Traumflug/Generation_7_Electronics/release documents/ExtensionBoard-USB-B 1.0 Layout.png

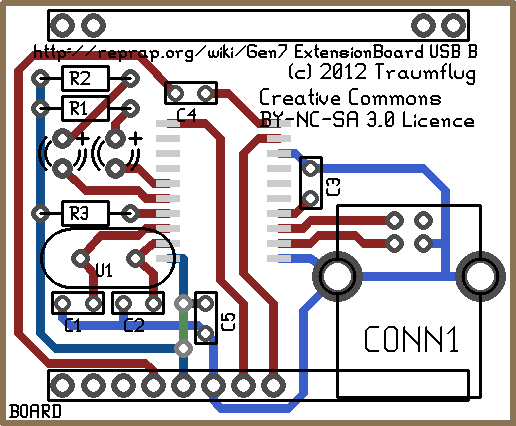
release documents/ExtensionBoard-USB-B 1.0 Layout.png
