Traumflug/Generation_7_Electronics/release documents/Gen7Board-ARM 2.0 Layout.png

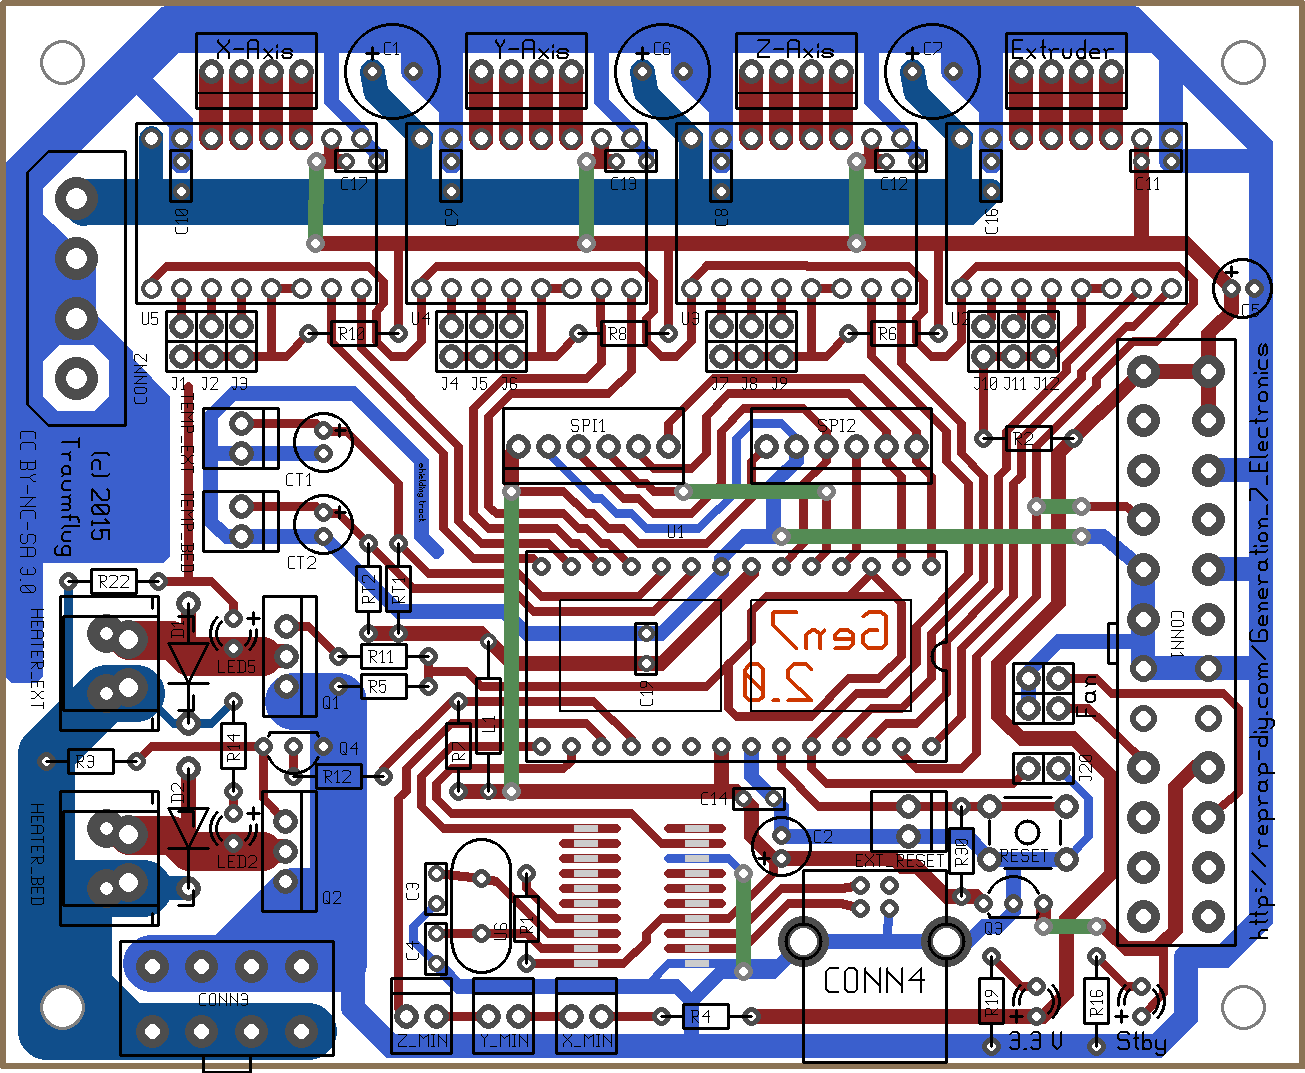
release documents/Gen7Board-ARM 2.0 Layout.png
