Traumflug/Generation_7_Electronics/release documents/OptoEndstop Layout.png

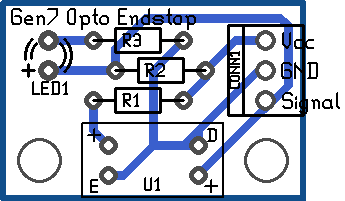
release documents/OptoEndstop Layout.png
