Traumflug/Generation_7_Electronics/release documents/SevenSwitch 1.2 Layout.png

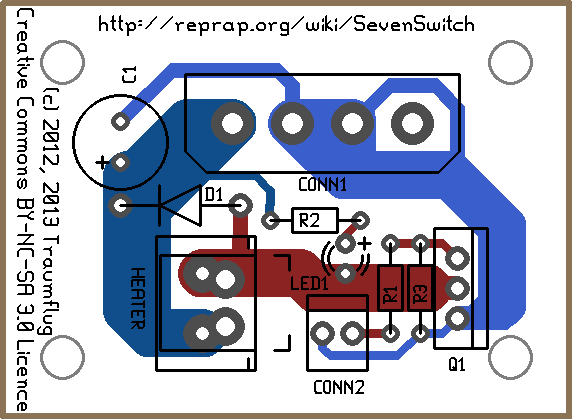
release documents/SevenSwitch 1.2 Layout.png
