Traumflug/Generation_7_Electronics/(threads)

Thread 22 (2015-03-27):

PCB Layout is not mirrored

yashunandansureka, 2015-03-27:
I was trying to make this board and while making the board using toner transfer method, i realized that the pcb layout given in the pdf for the main board is not mirrored thought at the bottom it says it is.
Can you  update it?

alfadex, 2015-03-27:
you can do this with your program, what program do you use ??

yashunandansureka, 2015-03-27:
Actually i don not use any program. I never had the need to (Until now). I was directly printing the design on glossy-paper and then transferring it on PCB.
I tried installing gEDA but its not opening on my PC.
Any options that you suggest?

alfadex, 2015-03-27:
i don't have to search in github , upload the *.brd you want to mirror , do you want to mirror it to pdf?jpg?*brd again?

yashunandansureka, 2015-03-27:
I do not have a ".brd" extension for any file which i downloaded from this repository. I have a pdf from which i am printing directly.

alfadex, 2015-03-27:
go to page 2 , it is mirrored

https://www.dropbox.com/s/tfbd6ic4uh6kdqa/Gen7Board%201.4.1%20Layout.pdf?dl=0

yashunandansureka, 2015-03-28:
thanks dude...but this is for version 1.4. I am building version 1.5.

Thread 23 (2016-09-30):

Consume on 5v With bed

feiltom, 2016-09-30:
Hello i don t understand why when i turn on my heated bed i have 1.5A on 5v.
Sorry for my english

Traumflug, 2016-10-01:
I don't even understand what you're talking about. Is it about a SevenSwitch?

feiltom, 2016-10-03:
no on my Gen7 Board-AVR 1.5
I have inverse heated bed with my jHead  and same problem
it is mount with  RLB 8743
thanck you

feiltom, 2016-10-04:
I thinck the common ground on 5v and 12v give me a false result on my ammeter

Closed 2016-10-04.

Thread 24 (2017-03-09):

Could someone help me get mcp2200-forwarder to work on an Atmega32u4 microcontroller?

taa1, 2017-03-09:
Hi,

I'm attempting to use mcp2200-forwarder.c on my PowerPC Mac Mini OS X 10.5.8 (Leopard) to talk to a [BlinkyTape device](https://www.adafruit.com/product/1605) that has a Atmega32u4 microcontroller. I changed mcp2200-forwarder.c to have the correct hardcoded USB vendor and product ID (1d50 and 605e respectively).

When I run the compiled mcp2200-forwarder, I get the following results:

~~~
$ ./mcp2200-forwarder -vvv -l /tmp/ACM0
device_added()
Device added.
find_interfaces()
Scanning interfaces ...
Interface 0x00001703.
Interface class 2, subclass 2.
Interface has 1 endpoints.
PipeRef 1: direction in, transfer type interrupt, maxPacketSize 16.
Choosing this interface as Interrupt.
Interface 0x00001A03.
Interface class 10, subclass 0.
Interface has 2 endpoints.
PipeRef 1: direction out, transfer type bulk, maxPacketSize 64.
PipeRef 2: direction in, transfer type bulk, maxPacketSize 64.
Choosing this interface as Bulk.
... interface scan done.
send_bridge_setup()
Failed to take down DTE & RTS. Ignoring. (e000404f)
Failed to set baud rate & co. Ignoring. (e000404f)
Failed to raise DTE & RTS. Ignoring. (e000404f)
Unable to set up USB-UART bridge. (e000404f)
close_interface()
device_removed()
pty_open()
Terminal name: /dev/ttys002
Created symlink to /tmp/ACM0
~~~

When I start a second shell session and run a perl script to use `/tmp/ACM0`, nothing happens on the BlinkyTape device and there's no error displayed. The perl script acts like it is happily sending the data to the BlinkyTape device because it takes a few seconds to do so, just like would happen if it was working correctly.

When I return to the first shell session running mcp2200-forwarder, it shows only one new line:

~~~
pty_read(), event 0x0002
~~~

When I contacted the BlinkyTape development team, I got these responses (edited for brevity):

> It's a little hard to tell from the source code, but a potential issue is that the BlinkyTape is actually a composite USB device, meaning that it supports a few other interfaces besides TTY-ACM (this was to make it compatible with the default Arduino Leonardo firmware). It looks like that code is ... finding the right interfaces, however I'm not sure how to interpret the addresses '0x00001703' or '0x00001A03'. [The output from USB Prober] shows that the computer is seeing the USB device just fine, so I think you're on the right track.

Output from USB Prober (starting at highlighed line 81) on my Mac: http://pastebin.com/Br0najQt
Output from 'lsusb' from BlinkyTape developer's Linux machine: http://pastebin.com/xjL1jZLR

I _think_ I'm close to getting mcp2200-forwarder to work. Can anyone help?

Thread 25 (2018-06-23):

Cannot connect after programming.

ZKing1000, 2018-06-23:
I've successfully programmed my gen 7 board as shown on the wiki, but now when I try to connect from repetier host I get no response, but a communication timeout... I'm not sure what to do. I can't get any response really. I don't know how to troubleshoot this. Thanks.

alfadex, 2018-06-23:
you have to test another ftdi board

Traumflug, 2018-06-23:
I'd start with connecting by a serial port terminal (GtkTerm, PuTTY, ...) to see whether communications is actually faulty. Then Pronterface. Repetier host is known to have its own idea of how communications should be and ignoring standards to some extents.

ZKing1000, 2018-06-23:
Connecting through the command, 'sudo screen /dev/ttyACM0 115200', resulted in a blank terminal. I haven't had much success installing pronterface on linux, but when I've tested it in windows, I haven't had much success either... I don't know how to get any real response from this thing.

ZKing1000, 2018-06-23:
The mcp2200 seems to functioning properly, but no response from the microcontroller, even though programming was successful.

ZKing1000, 2018-06-24:
Maybe there's some type of test firmware?... I do need to buy an oscilliscope... I assume the lpc1114 is working.

ZKing1000, 2018-11-18:
@Traumflug On second thought, are there any conditions under which you could provide my an lpc1114 or two separately? I could buy a couple from you if that is possible. Or if anyone is aware of any breakout boards I could order for the SMD form of this chip, then that may be an option, as I don't believe I can order the DIP form myself without a quote. Thanks.

Jacky2k, 2018-11-18:
Don't know what you are talking about, but you can buy breakout boards
everwhere, e.g.: https://www.adafruit.com/product/1377
You can order the chip for example at:
https://www.arrow.com/en/products/lpc1114fbd483021/nxp-semiconductors
Arrow currently has free express shipping with no minimum order amount.

Am 18.11.18 um 07:33 schrieb Holden Green:
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

Traumflug, 2018-11-18:
@ZKing1000, of course you can get a couple of them. It's not explicitly mentioned, one can get every part as a spare part: https://www.reprap-diy.com/start

Thread 27 (2023-05-10):

Gen7 1.3board with marlin 2.x firmware trying to update (is there a way?)

wasteoinc, 2023-05-10:
This is partly a question , partly a tribute and a thank you :)

I have a Gen7 1.3 board with 644p@20Mhz repetier firmware and I was trying to update to marlin 2.x . Marlin still supports our boards , but platformIO and sanguinoglu (which also has 644p) seem to give an uploading error.

I then tried arduino 1.0.5 where we have the relative board files for gen7 but this old IDE doesn't seem compatible with new marlin firmware.

So my question is , is there a path/way to upgrade to marlin 2.x , or am I banging my head to a wall?
Has anyone done it?

The board belongs to a self made PRUSA 2 that still works flawlessly :)
