Traumflug/Generation_7_Electronics/release documents/Gen7Board-ARM 2.0 Schematic.pdf

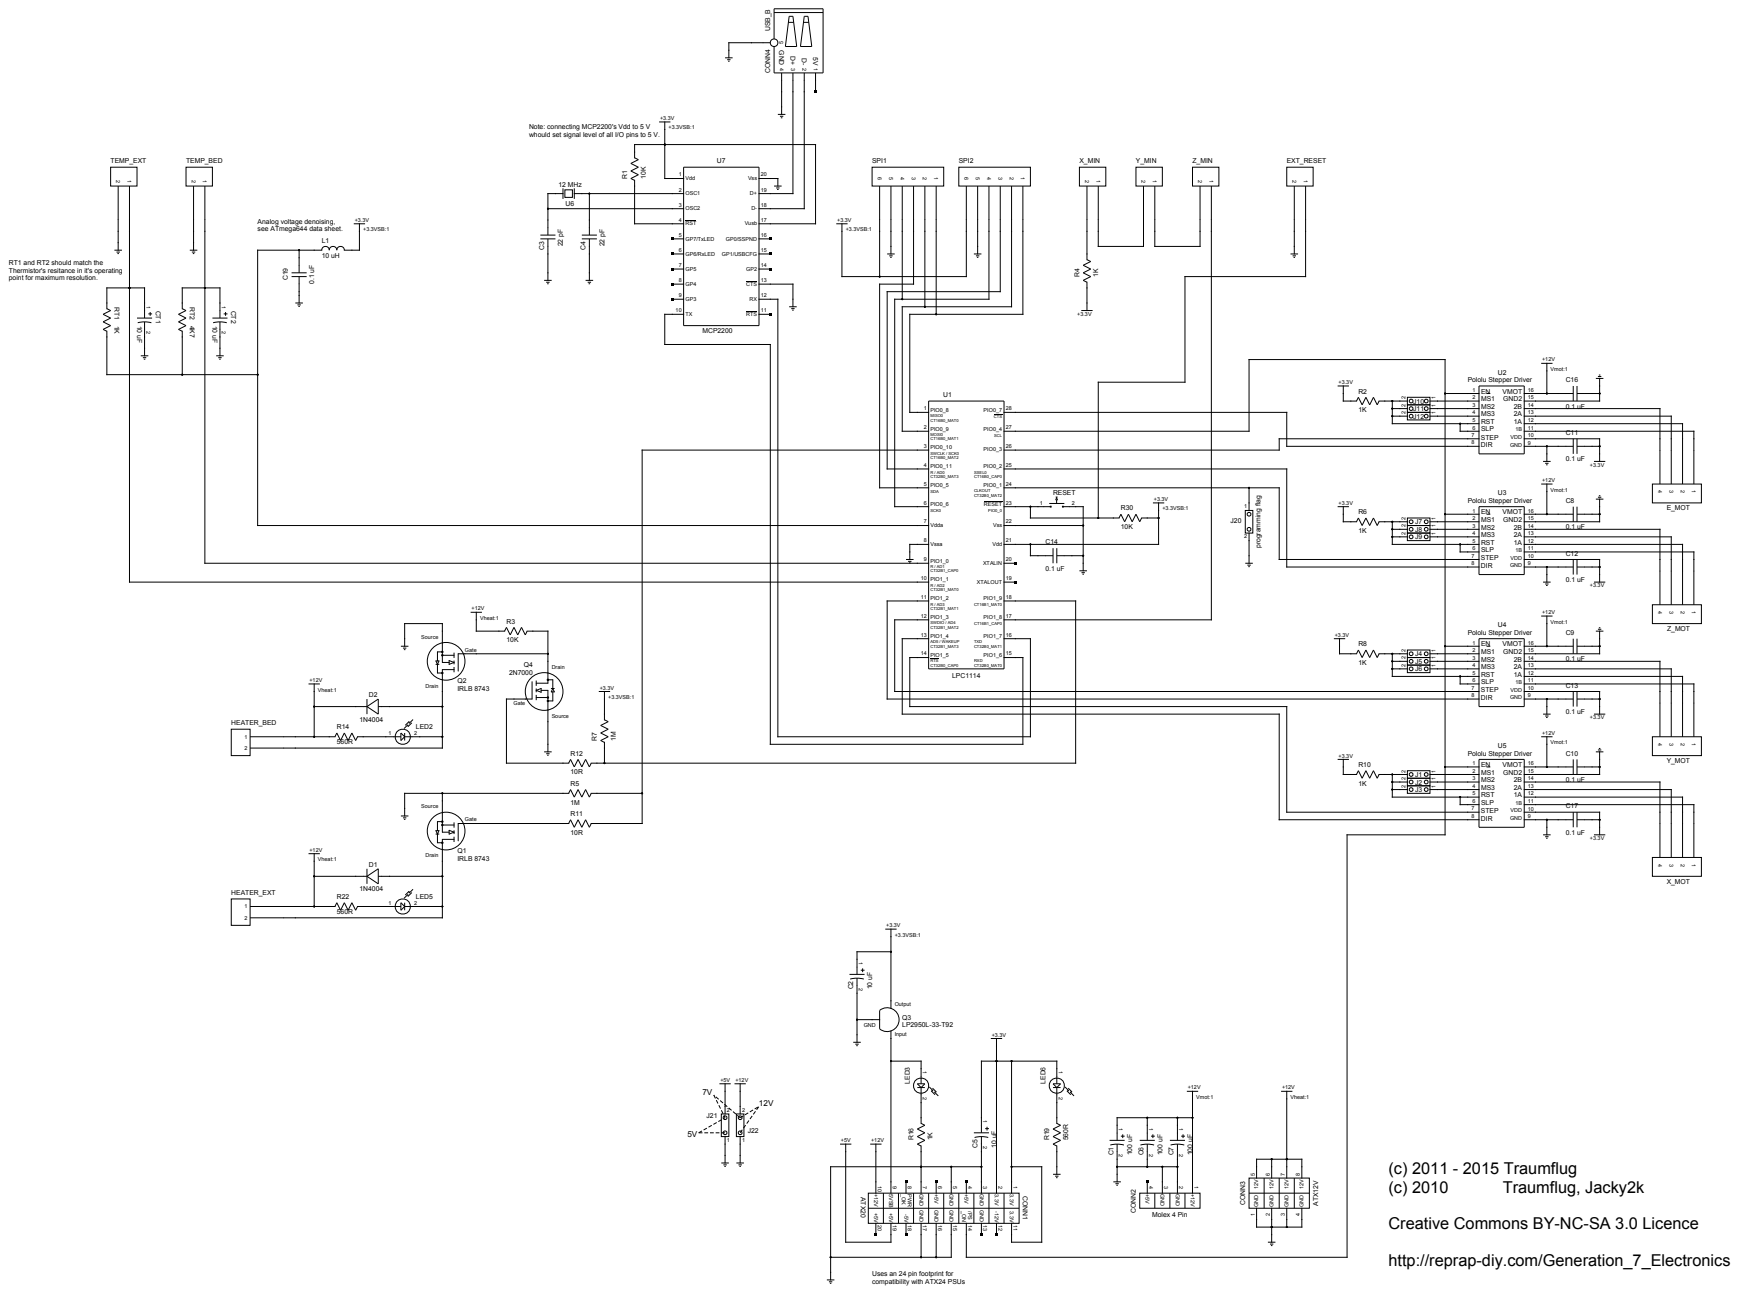
[picture p5: page 1]

whould set signal level of all I/O pins to 5 V.

RT1 and RT2 should match the
Thermistor's resitance in it's operating
point for maximum resolution.

Creative Commons BY-NC-SA 3.0 Licence

http://reprap-diy.com/Generation_7_Electronics

Uses an 24 pin footprint for
compatibility with ATX24 PSUs
