Traumflug/Generation_7_Electronics/release documents/OptoEndstop Schematic.pdf

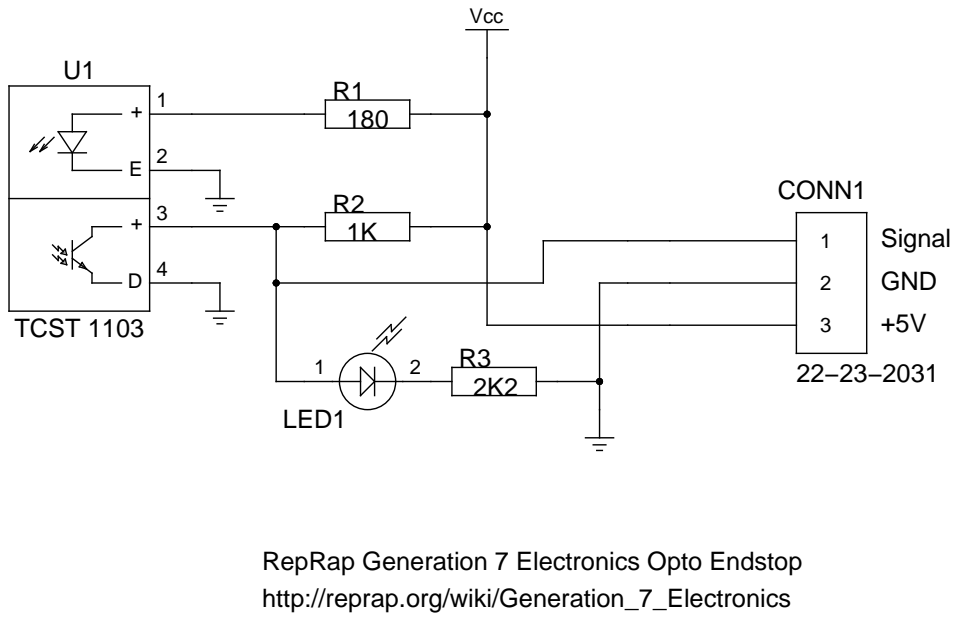
[picture p6: page 1]
TCST 1103

RepRap Generation 7 Electronics Opto Endstop
http://reprap.org/wiki/Generation_7_Electronics
