Traumflug/Generation_7_Electronics/release documents/Gen7Board-ARM 2.0 Layout.pdf

# Gen7Board-ARM.pcb

# 1. Table of Contents (This Page) Created on Thu Feb 18 16:01:24 2016

# 2. solder 3. component 4. outline 5. plated-drill 6. componentmask 7. soldermask 8. topsilk 9. bottomsilk 10. bottompaste 11. topassembly 12. bottomassembly 13. fab

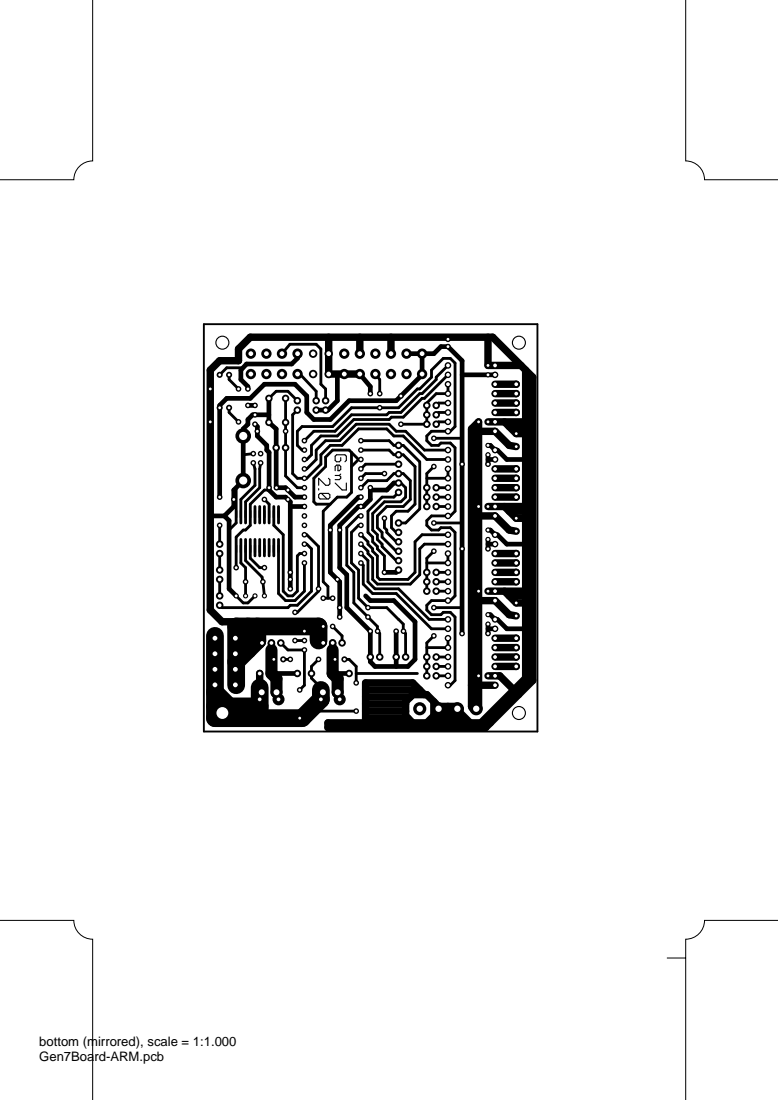
[picture p7: page 2]

bottom (mirrored), scale = 1:1.000

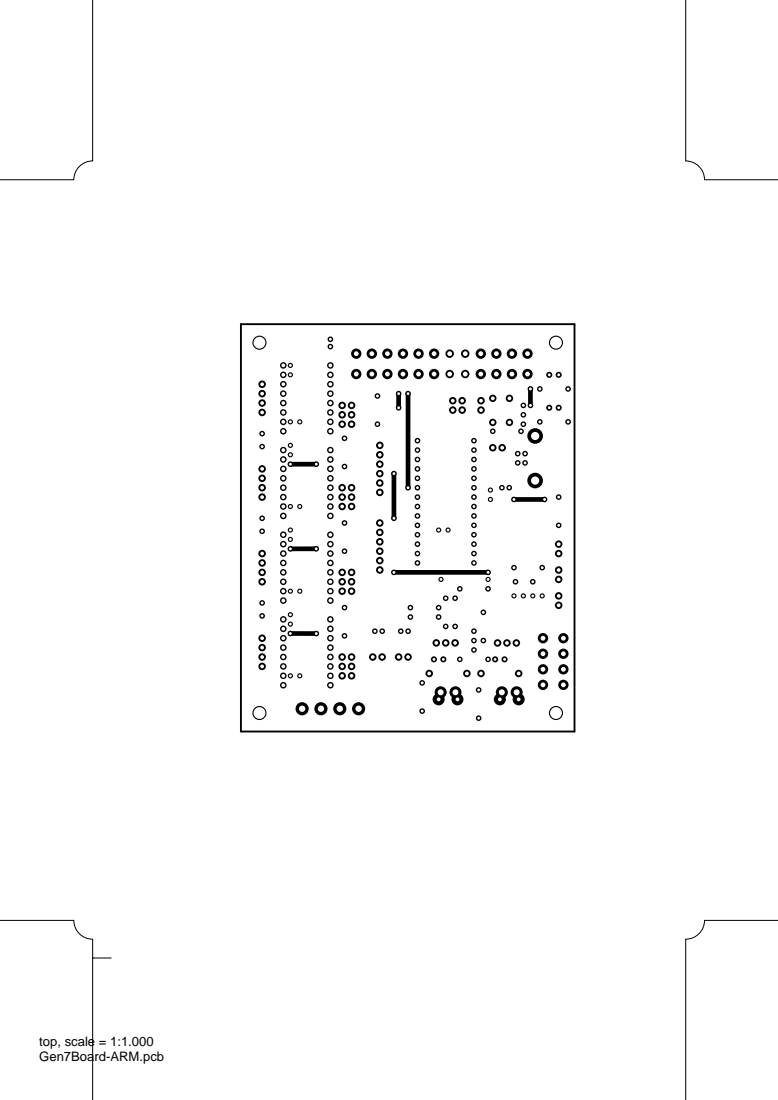
[picture p8: page 3]
top, scale = 1:1.000

outline, scale = 1:1.000

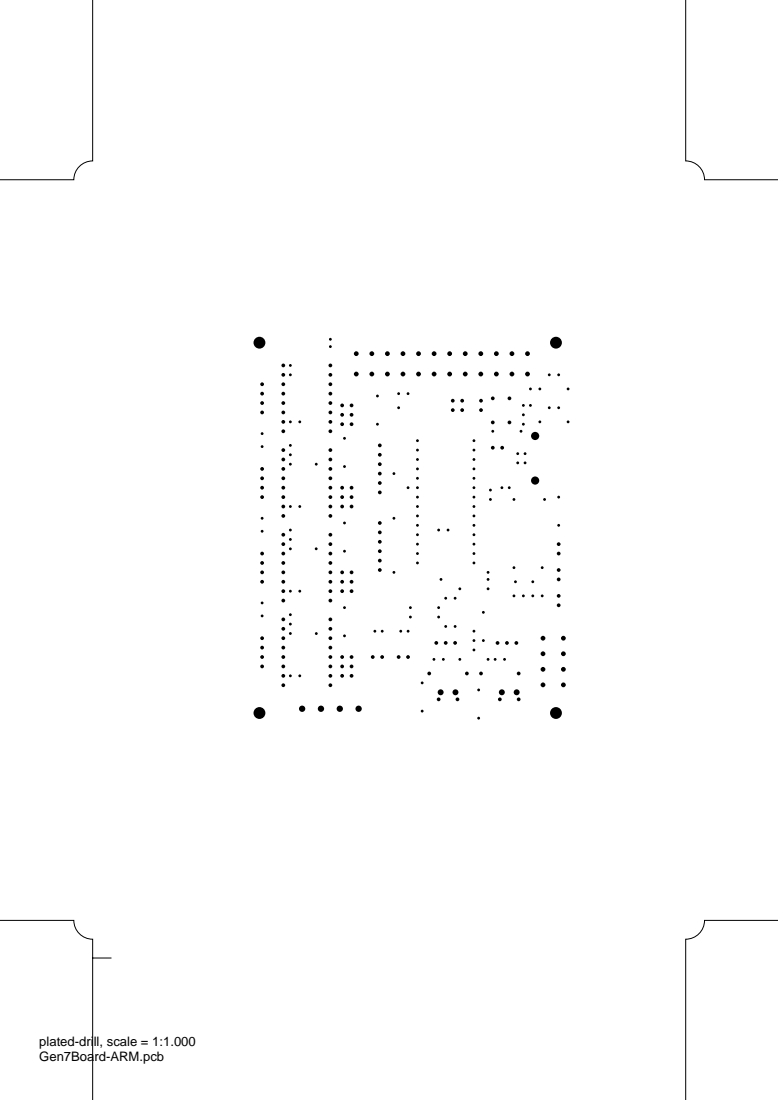
[picture p9: page 5]

plated-drill, scale = 1:1.000

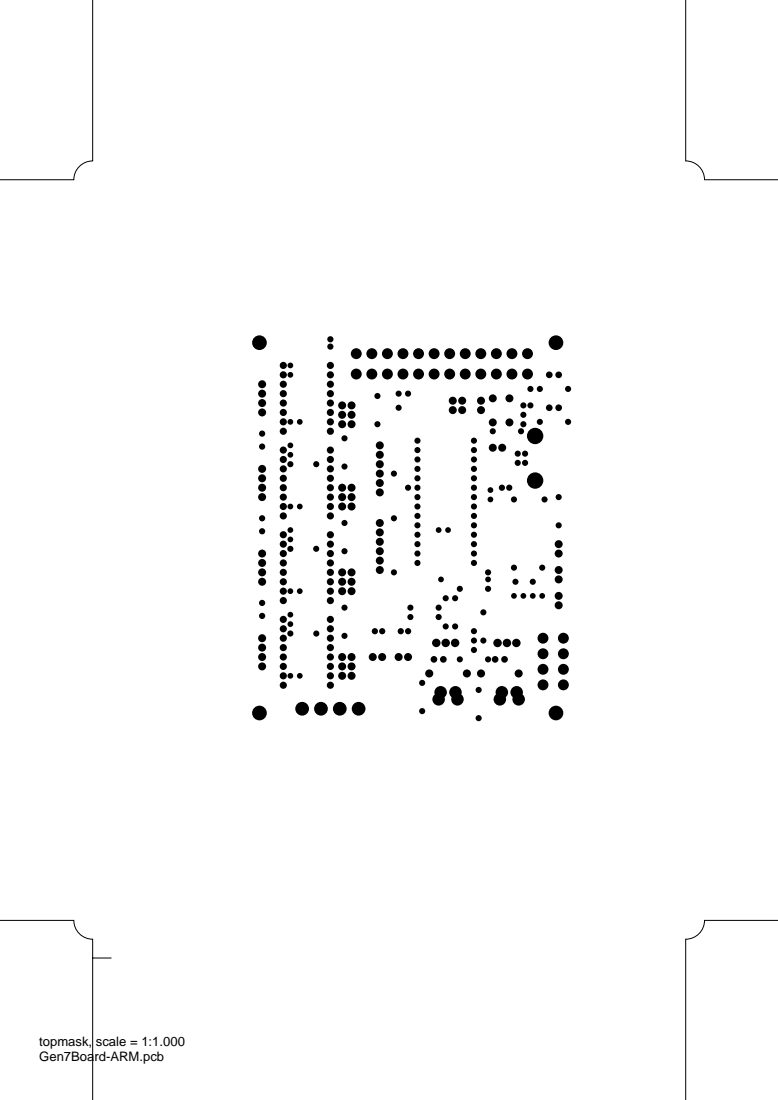
[picture p10: page 6]
topmask, scale = 1:1.000

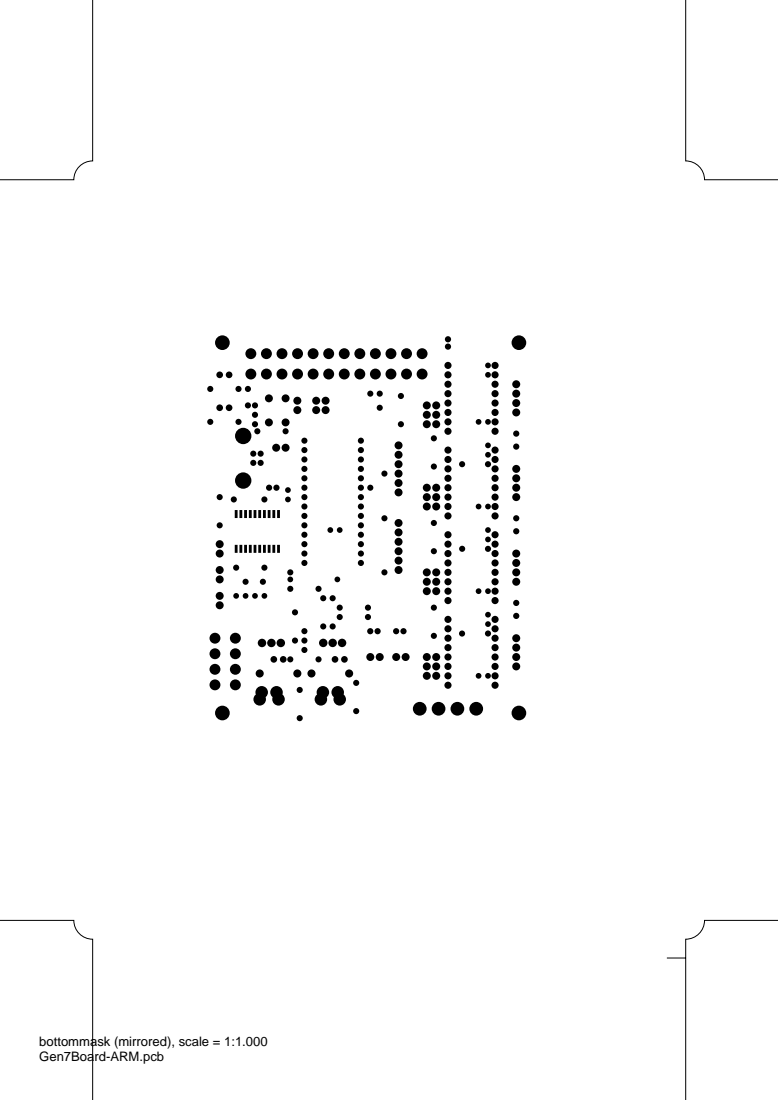
[picture p11: page 7]

bottommask (mirrored), scale = 1:1.000

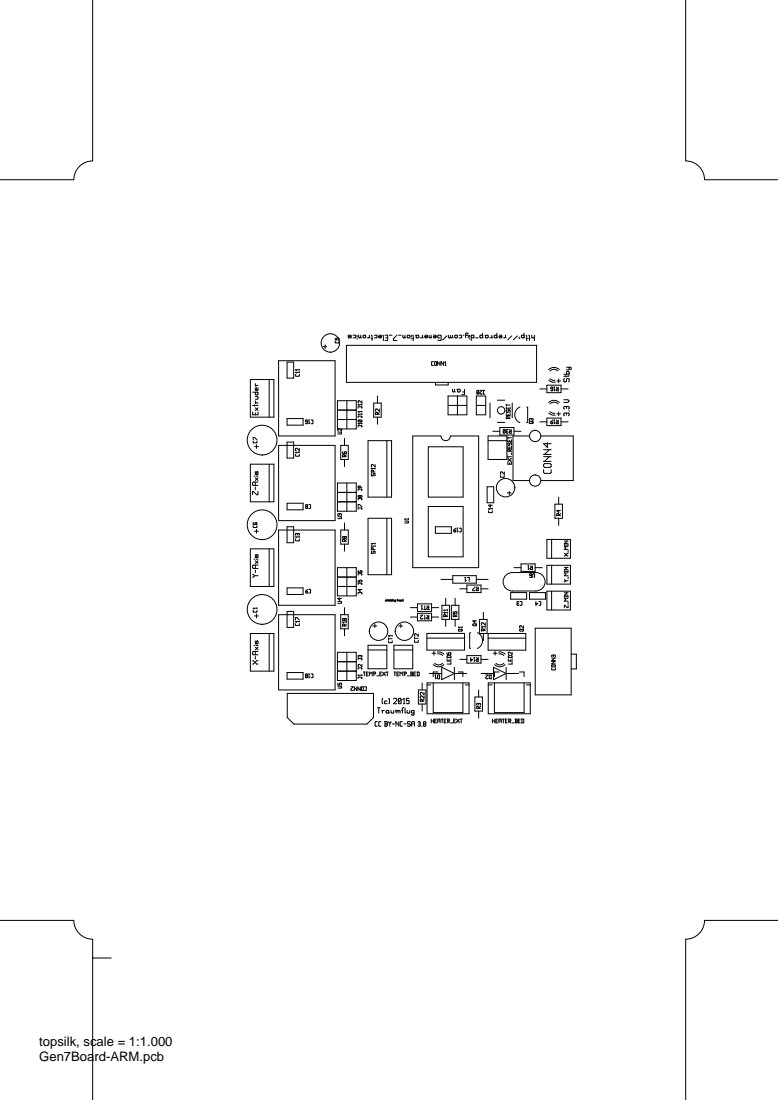
[picture p12: page 8]
topsilk, scale = 1:1.000
