Traumflug/Generation_7_Electronics/release documents/SevenSwitch 1.2 Layout.pdf

# SevenSwitch.pcb

# 1. Table of Contents (This Page) Created on Sun Aug 11 21:05:15 2013

# 2. solder 3. component 4. plated-drill 5. componentmask 6. soldermask 7. topsilk 8. bottomsilk 9. topassembly 10. bottomassembly 11. fab

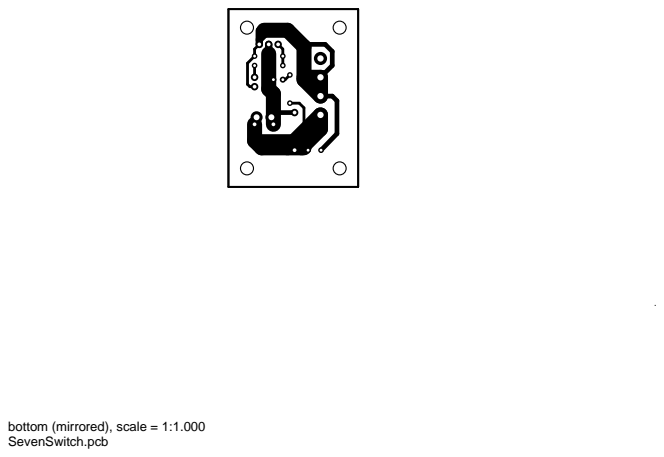
[picture p13: page 2]

bottom (mirrored), scale = 1:1.000

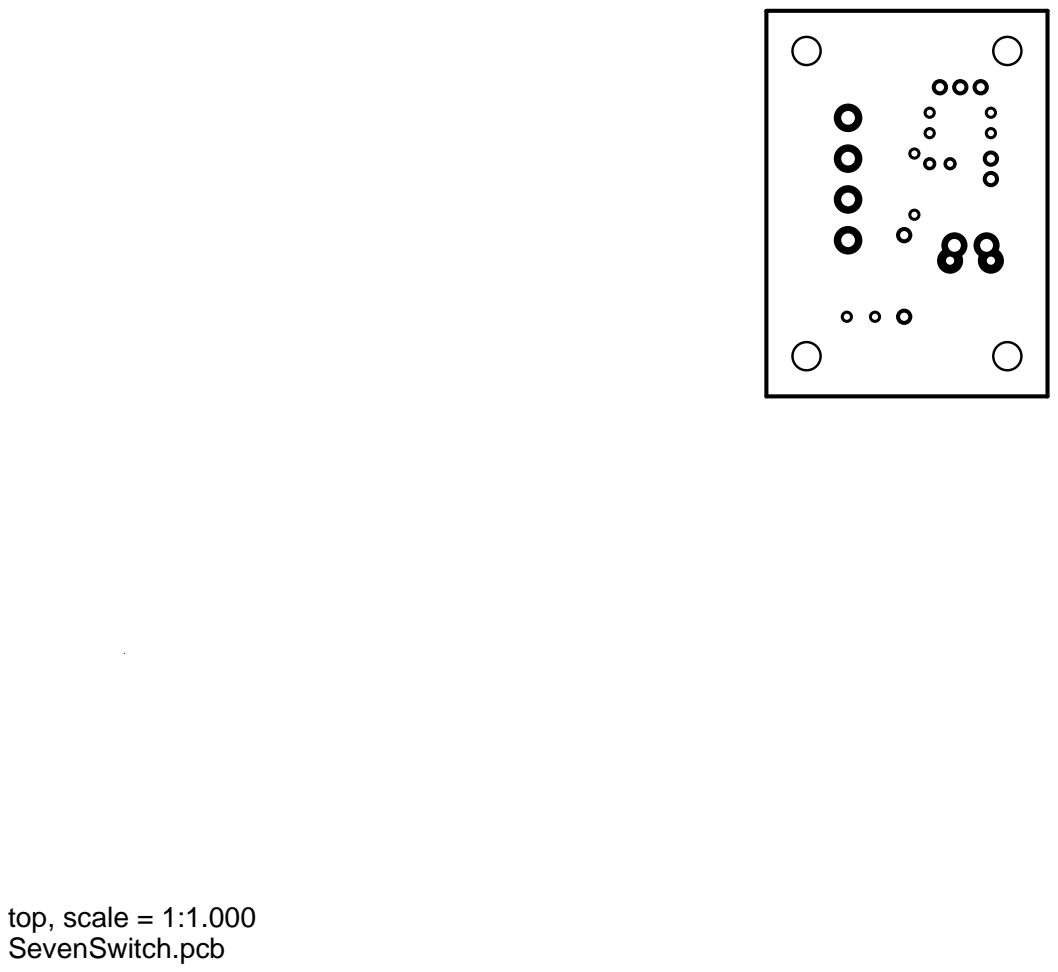
[picture p14: page 3]
top, scale = 1:1.000

plated-drill, scale = 1:1.000

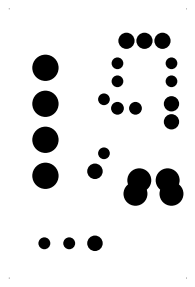
[picture p15: figure]

topmask, scale = 1:1.000

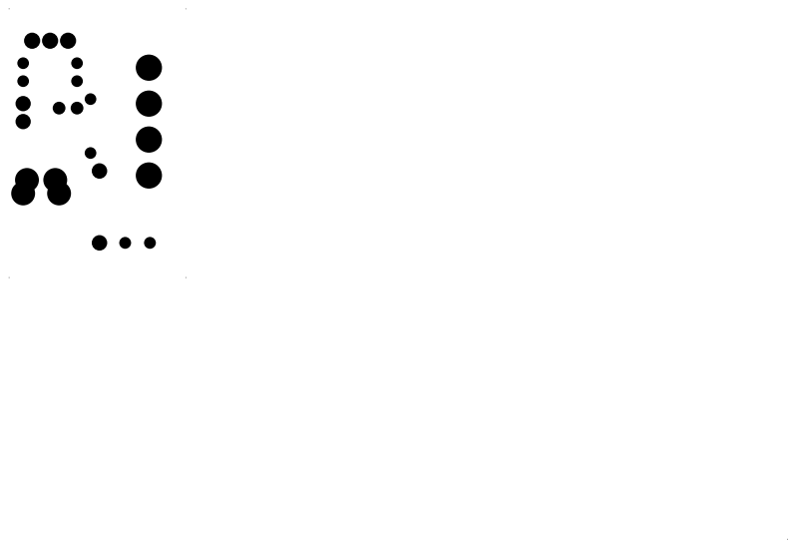
[picture p16: figure]

bottommask (mirrored), scale = 1:1.000

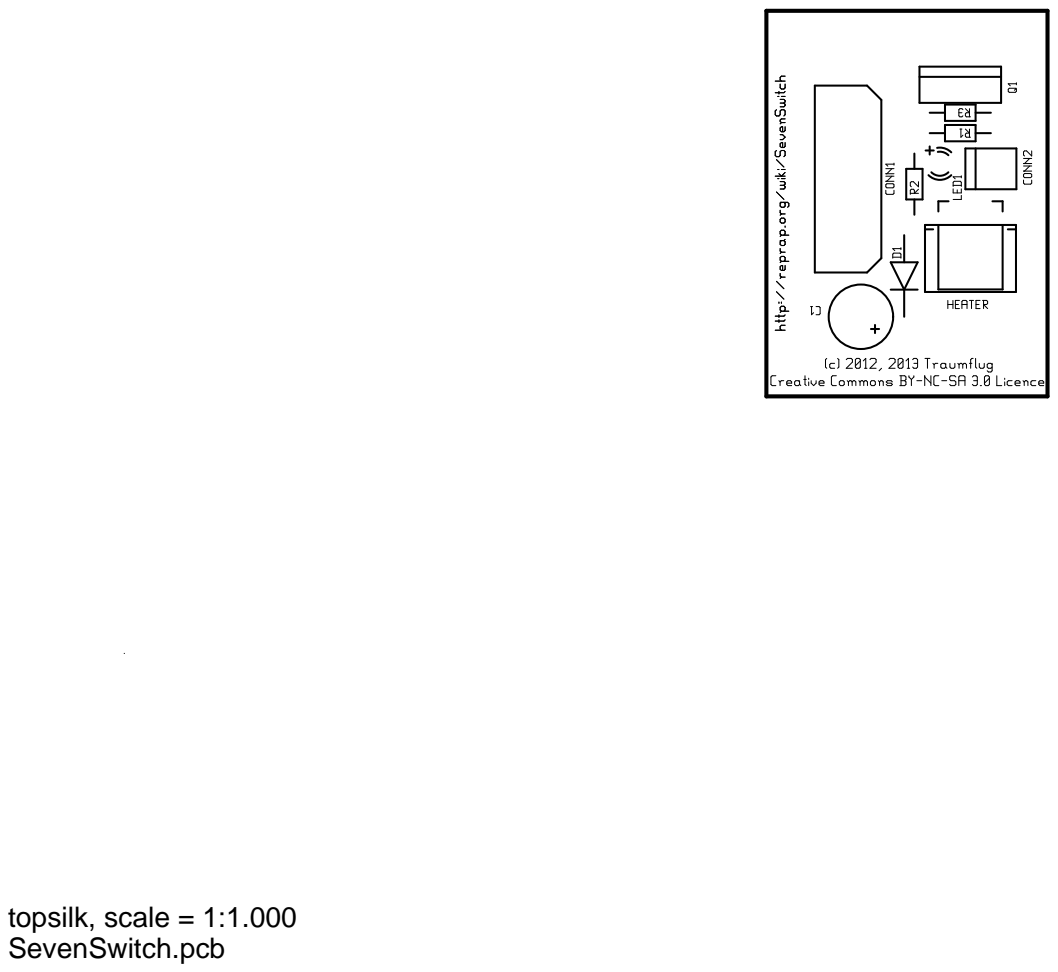
[picture p17: page 7]
topsilk, scale = 1:1.000

bottomsilk (mirrored), scale = 1:1.000

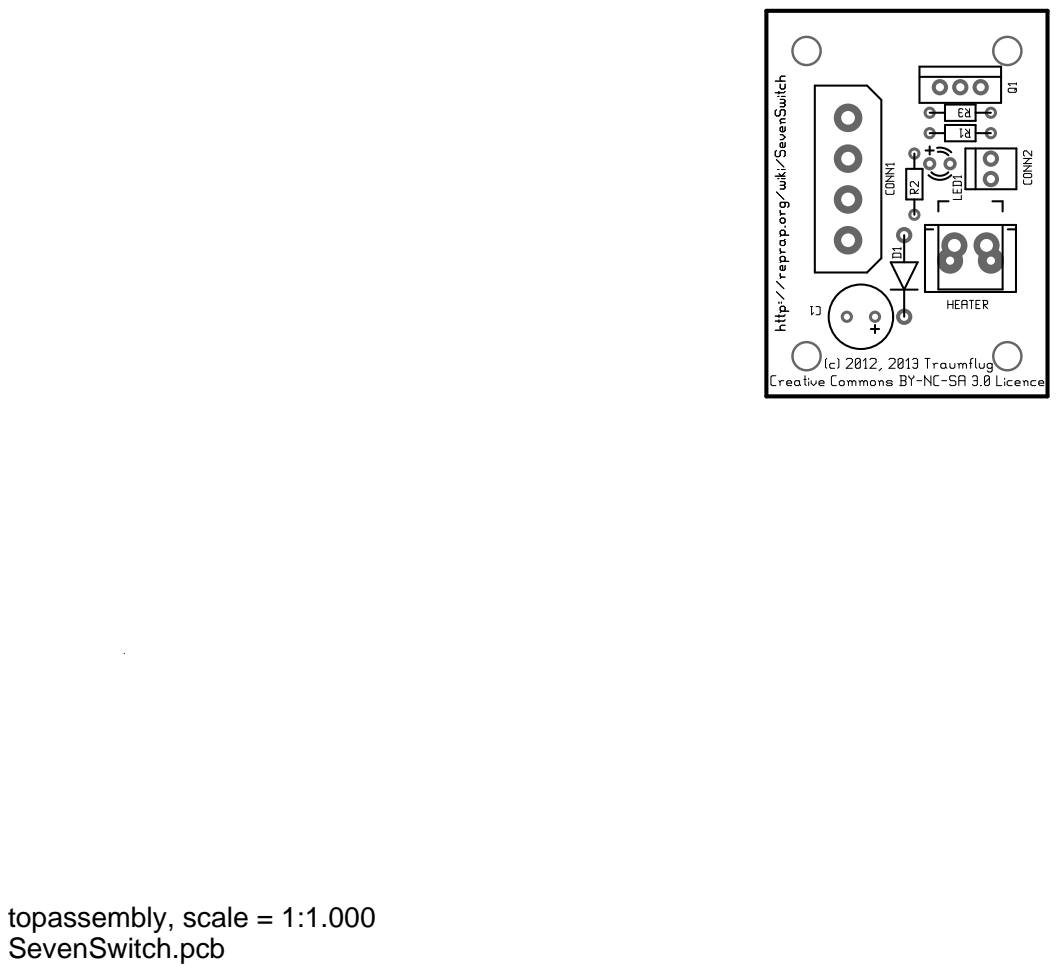
[picture p18: page 9]
topassembly, scale = 1:1.000

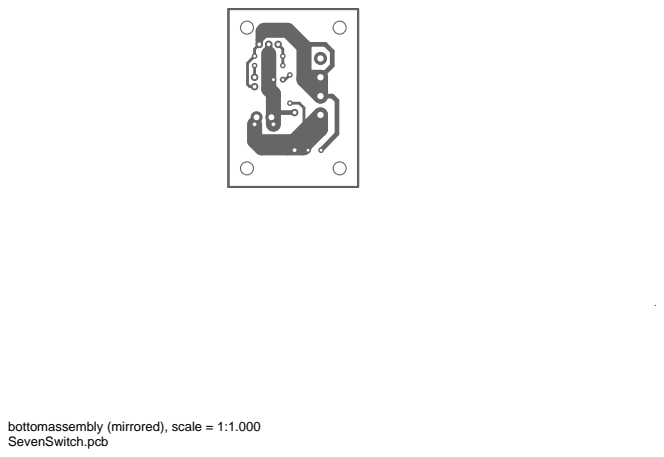
[picture p19: page 10]

bottomassembly (mirrored), scale = 1:1.000

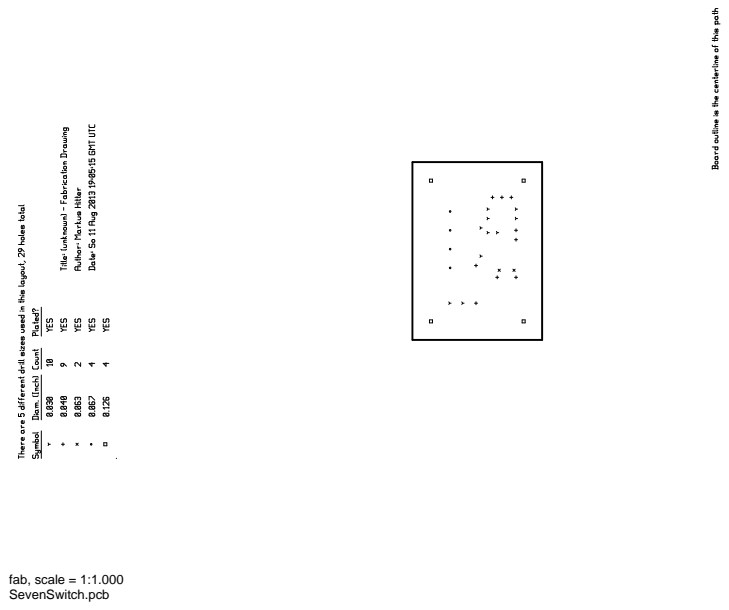
[picture p20: page 11]
fab, scale = 1:1.000
