Traumflug/Generation_7_Electronics/release documents/ExtensionBoard-USB-B 1.0 Layout.pdf

# ExtensionBoard-USB-B.pcb

# 1. Table of Contents (This Page) Created on Sun Dec 2 15:48:05 2012

# 2. solder 3. component 4. plated-drill 5. componentmask 6. soldermask 7. topsilk 8. bottomsilk 9. bottompaste 10. topassembly 11. bottomassembly 12. fab

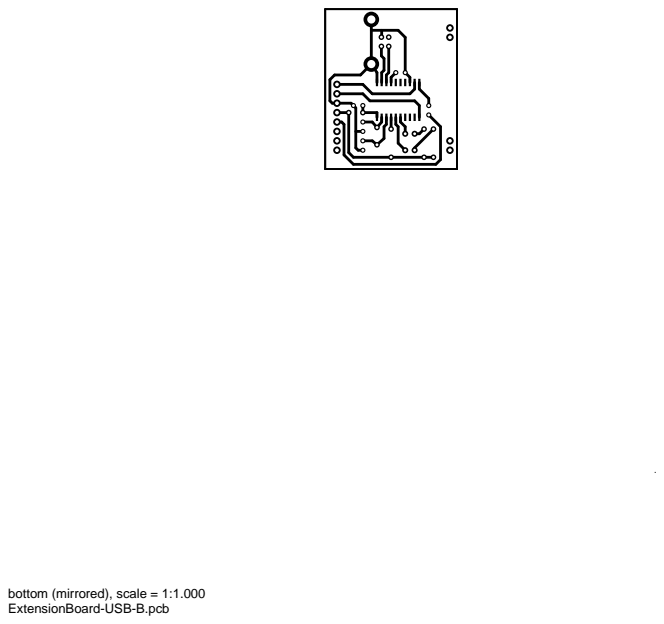
[picture p21: page 2]

bottom (mirrored), scale = 1:1.000

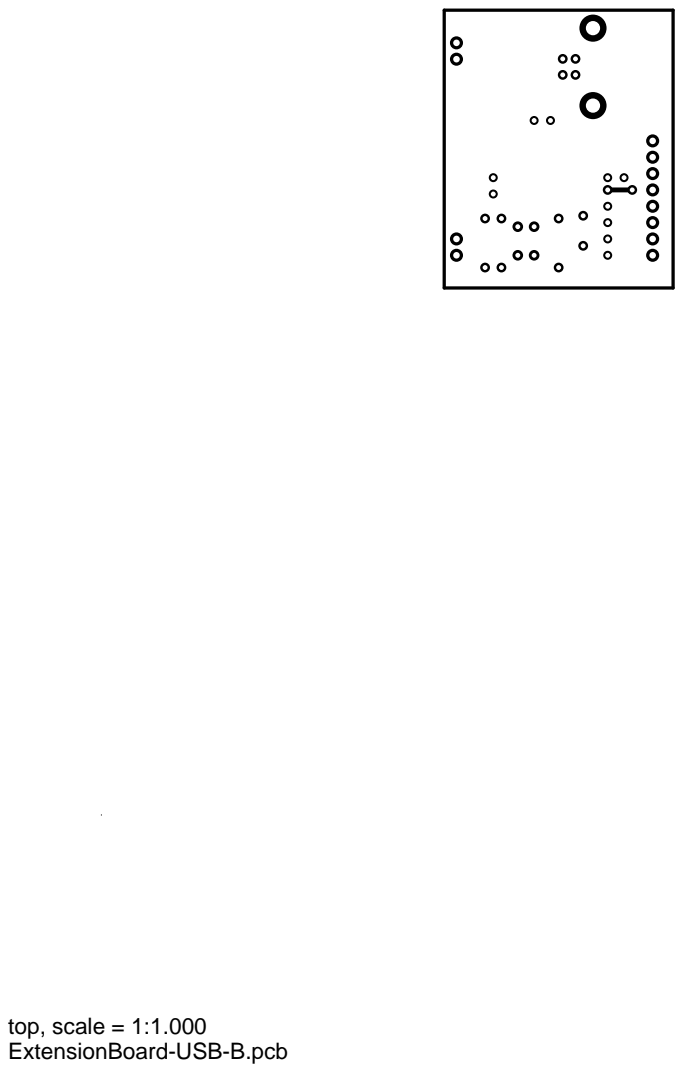
[picture p22: page 3]
top, scale = 1:1.000

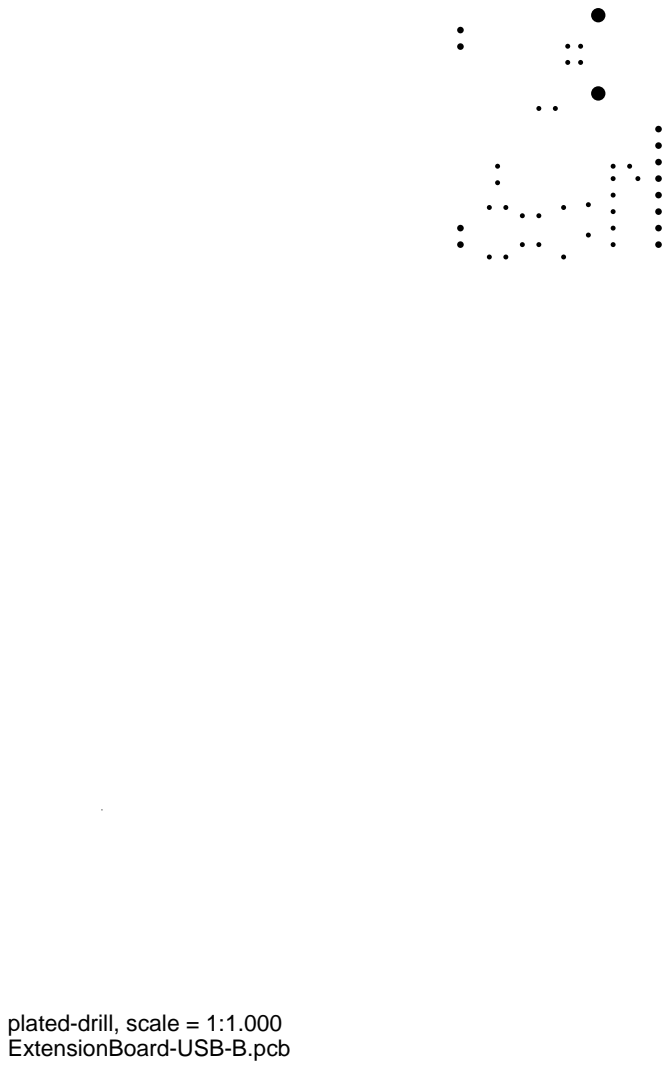
[picture p23: page 4]

plated-drill, scale = 1:1.000

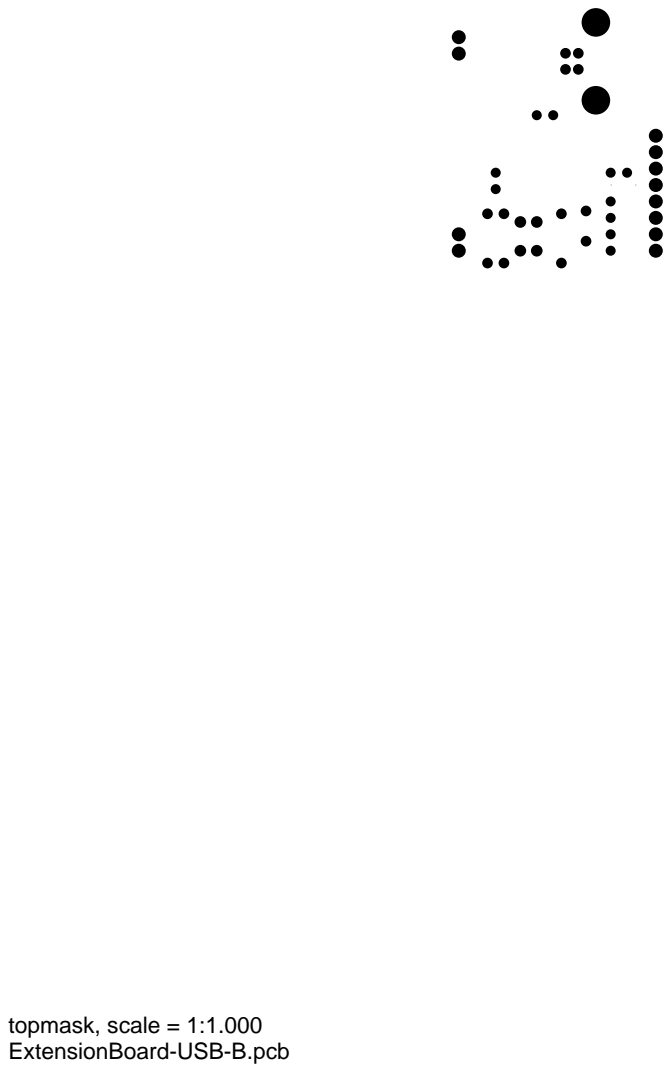
[picture p24: page 5]
topmask, scale = 1:1.000

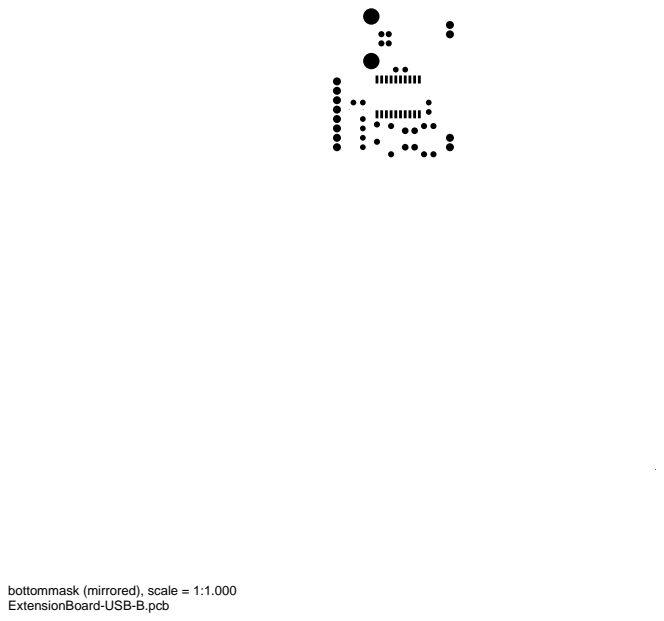
[picture p25: page 6]

bottommask (mirrored), scale = 1:1.000

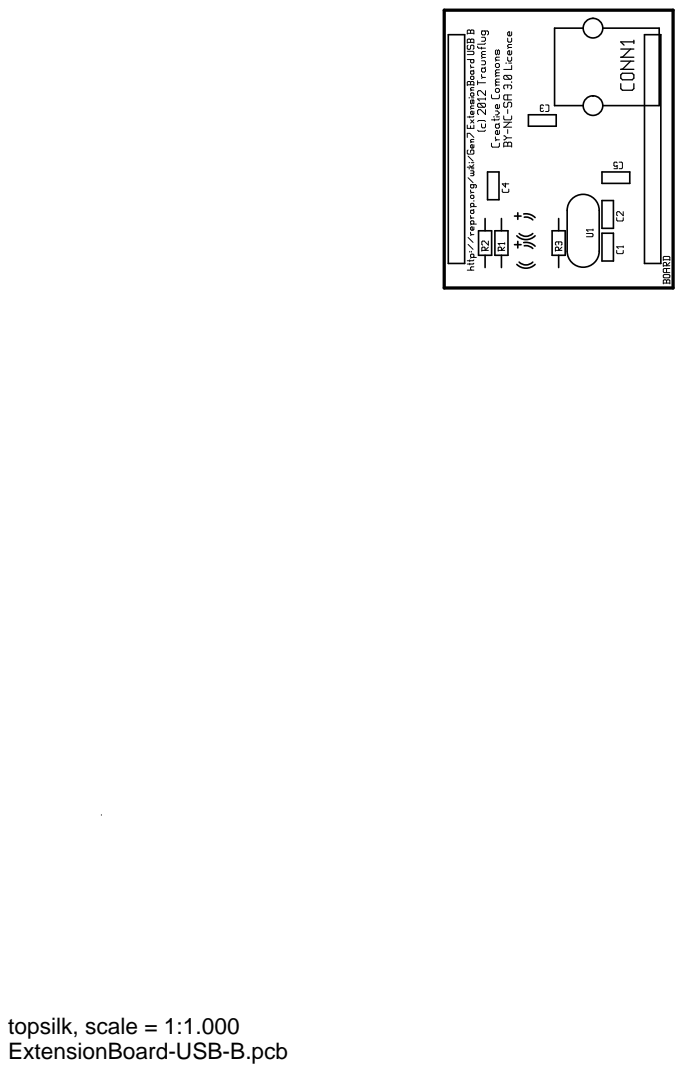
[picture p26: page 7]
topsilk, scale = 1:1.000
