Traumflug/Generation_7_Electronics/release documents/OptoEndstop Layout.pdf

# OptoEndstop.pcb

# 1. Table of Contents (This Page) Created on Tue Aug 16 22:38:10 2011

# 2. component 3. solder 4. plated-drill 5. componentmask 6. soldermask 7. topsilk 8. bottomsilk 9. topassembly 10. bottomassembly 11. fab

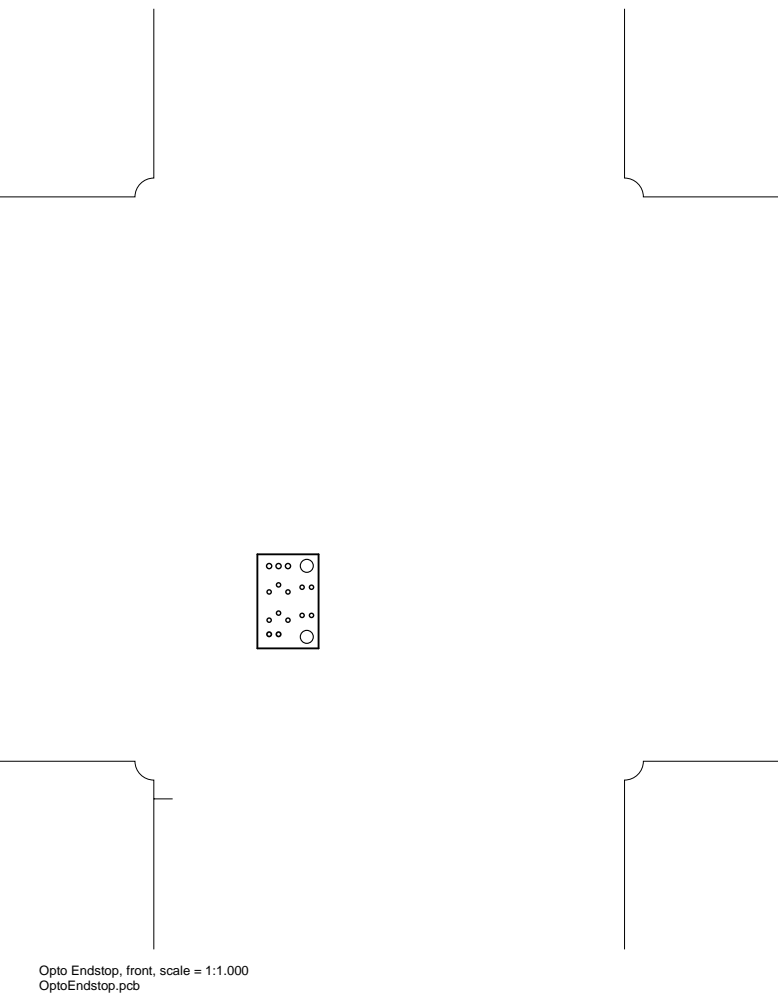
[picture p27: page 2]

Opto Endstop, front, scale = 1:1.000

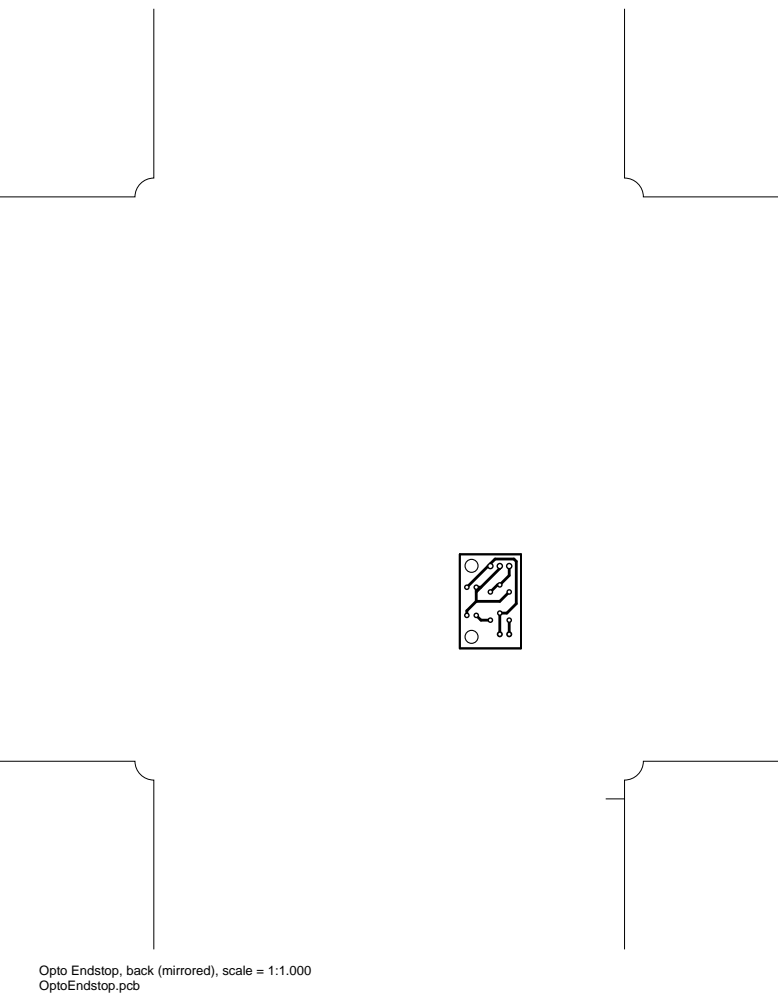
[picture p28: page 3]

Opto Endstop, back (mirrored), scale = 1:1.000

Opto Endstop, plated-drill, scale = 1:1.000

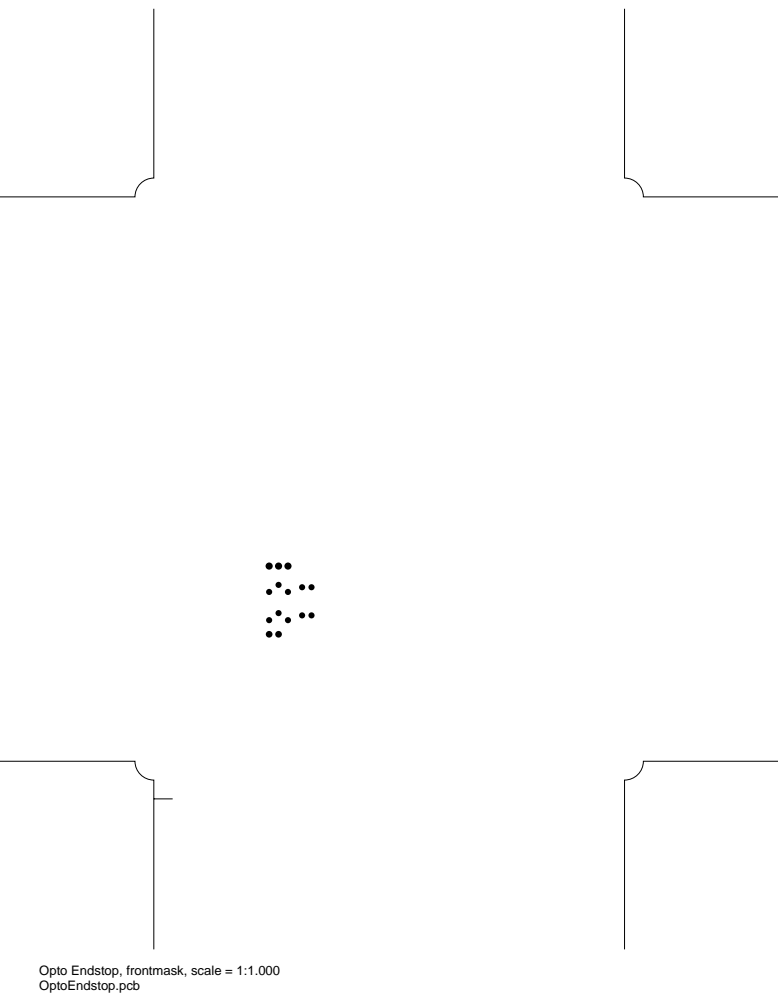
[picture p29: page 5]

Opto Endstop, frontmask, scale = 1:1.000

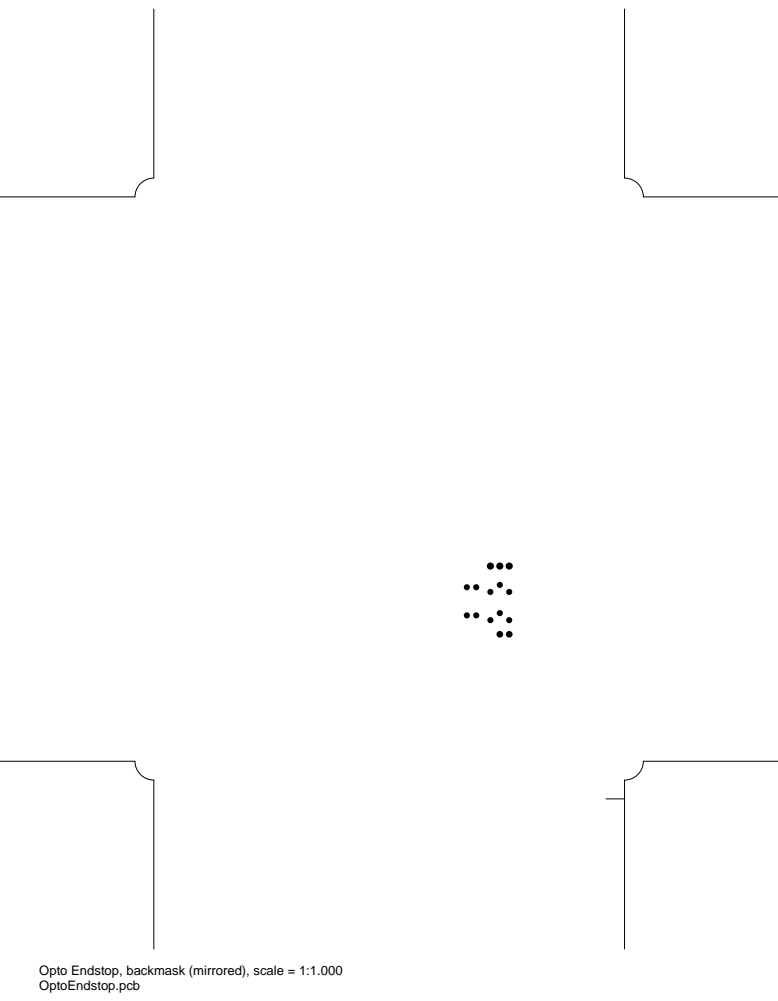
[picture p30: page 6]

Opto Endstop, backmask (mirrored), scale = 1:1.000

Opto Endstop, frontsilk, scale = 1:1.000

Opto Endstop, backsilk (mirrored), scale = 1:1.000

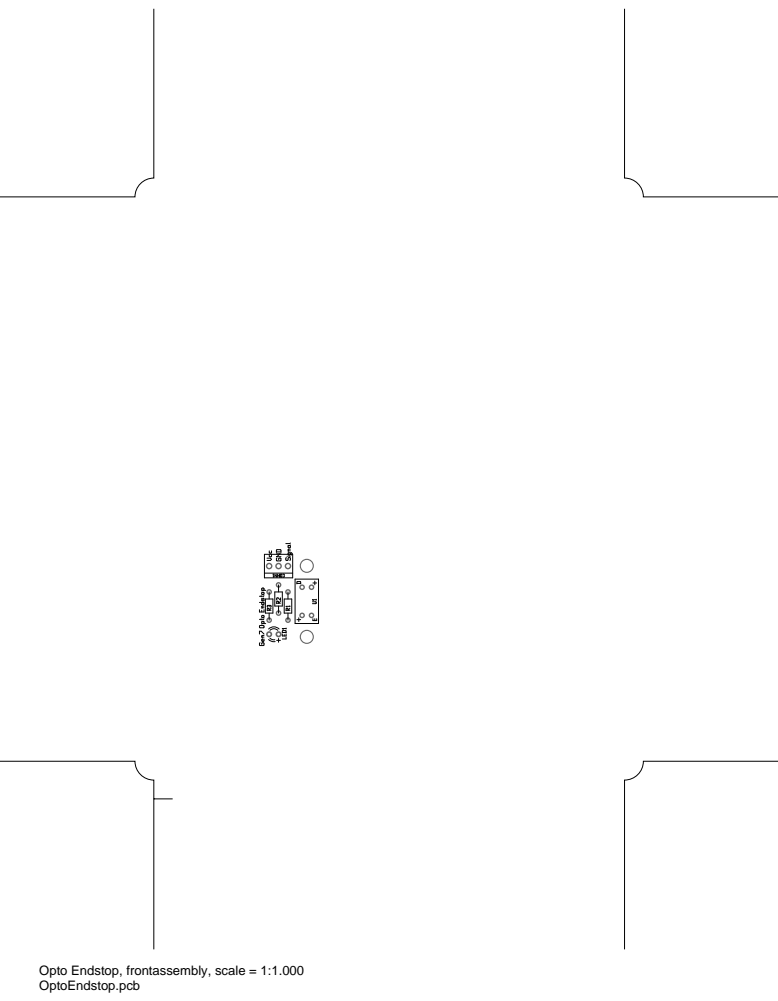
[picture p31: page 9]

Opto Endstop, frontassembly, scale = 1:1.000

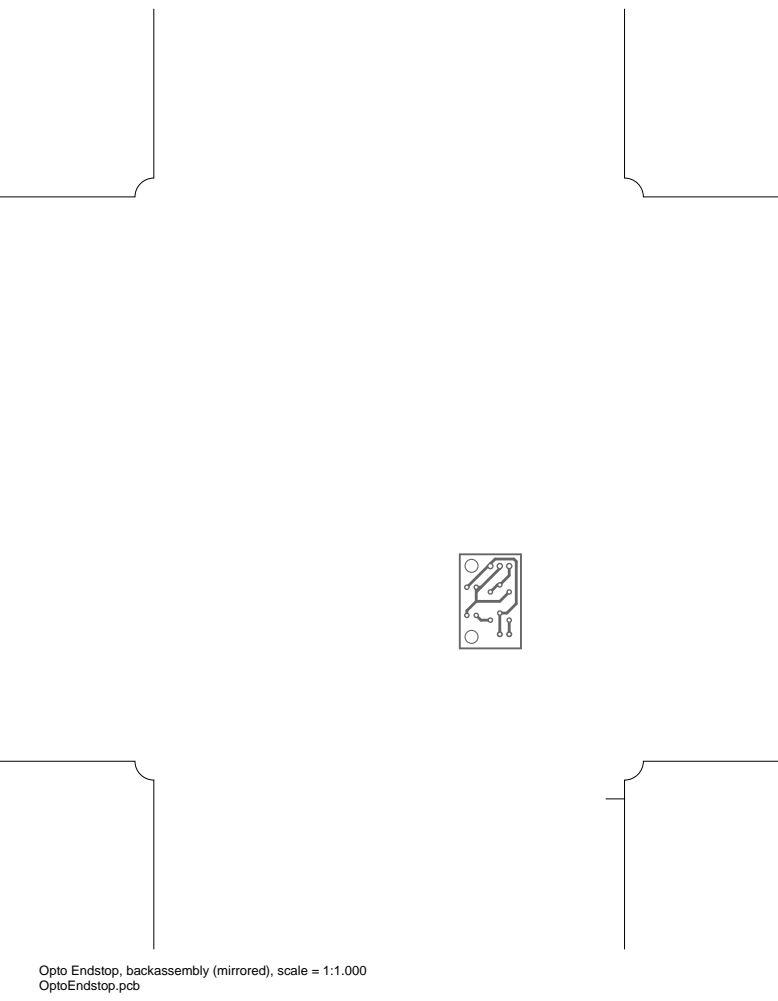
[picture p32: page 10]

Opto Endstop, backassembly (mirrored), scale = 1:1.000

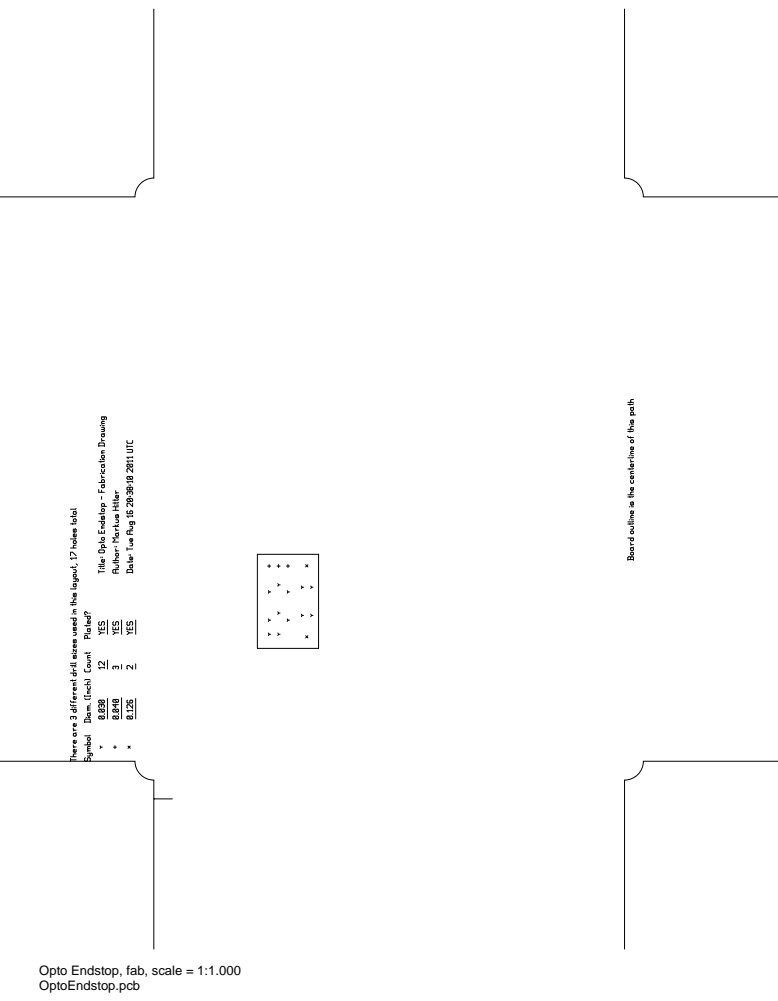
[picture p33: page 11]

Opto Endstop, fab, scale = 1:1.000
