Traumflug/Generation_7_Electronics/release documents/SevenSwitch 1.2 Schematic.pdf

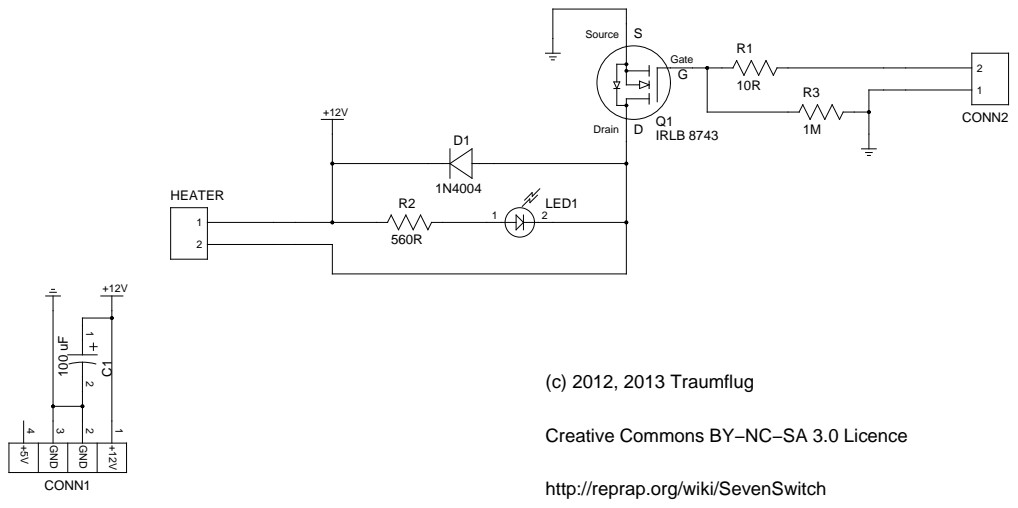
[picture p34: page 1]
(c) 2012, 2013 Traumflug; Drain; D Q1 IRLB 8743

Creative Commons BY−NC−SA 3.0 Licence

http://reprap.org/wiki/SevenSwitch
