Traumflug/Generation_7_Electronics/release documents/ExtensionBoard-USB-B 1.0 Schematic.pdf

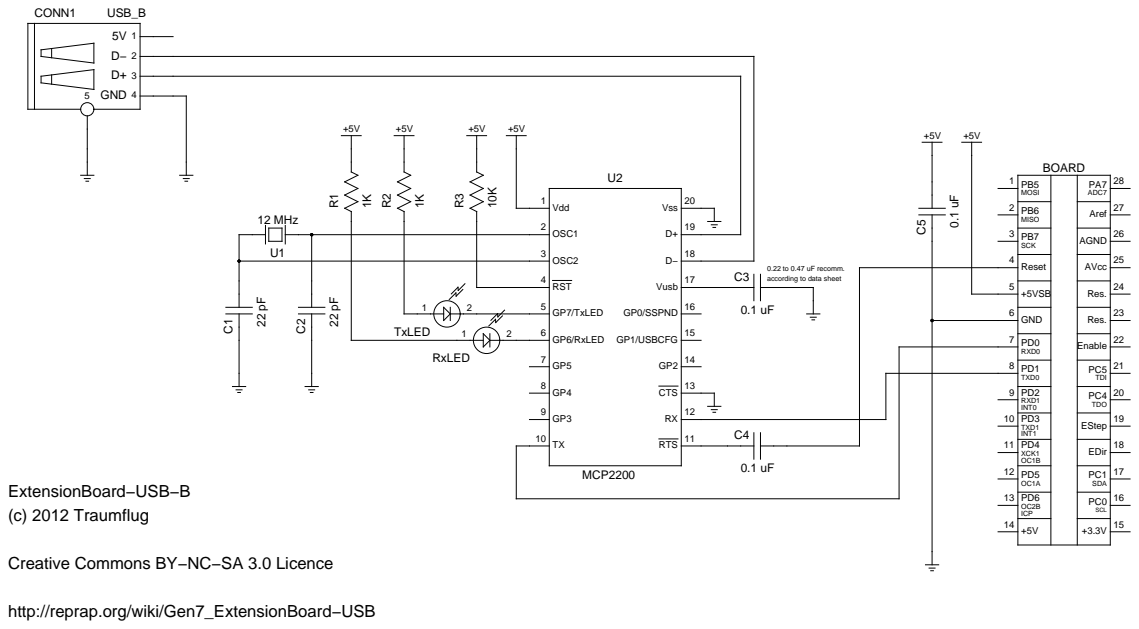
[picture p35: page 1]

OSC2 3

RST 4

according to data sheet

Creative Commons BY−NC−SA 3.0 Licence

http://reprap.org/wiki/Gen7_ExtensionBoard−USB
