Traumflug/Generation_7_Electronics/(list of files, drawings)

Other design files:
ExtensionBoard-USB-B.pcb
Gen7Board-ARM.pcb
Gen7Board.pcb
OptoEndstop.pcb
SevenSwitch.pcb
