Traumflug/Generation_7_Electronics/(commit log)

2010-10-10 Get started already!
    [Gen7Board.pcb, Gen7Board.sch]
2010-10-13 Replace schematic symbol for the ATX20 connector.
2010-10-13 Make use of the new ATX20 symbol in the schematic.
    [Gen7Board.sch]
2010-10-13 Add footprints for the ATX20 connector and the same, but with space for the 24-pin version reserved. The later isn't recognized by gsch2pcb yet.
2010-10-15 Add schematic symbol and data sheet for an H21LOB.
2010-10-15 Add schematic for the Opto Endstop. This circuitry is the same as the one for the OptoEndstop v2.1.
    [OptoEndstop.sch]
2010-10-17 Gen7Board.pcb: fix the layer grouping to actually have a working solder and component side.
    [Gen7Board.pcb]
2010-10-17 Fixed a few things around the ATX20 connector:
    - The ATX20 symbol had "J?" as the default name which clashes with jumpers.
    - The ATX20 footprint had in addition to the above wrong pin numbers.
    - Fitted the new ATX20 connector footprint onto the board.
    - Removed the GND pad as this somehow doesn't work and there's more
    than enough space on the wide GND tracks.
    [Gen7Board.pcb, Gen7Board.sch]
2010-10-17 Opto Endstop: use the same connector schematic symbol as in Gen7Board.
    [OptoEndstop.sch]
2010-10-17 Fix the Molex KK 100 3-pin connector footprint to comply with the data sheet.
2010-10-17 Gen7Board: replace 2-pin jumpers with solder jumpers.
    [Gen7Board.pcb, Gen7Board.sch]
2010-10-17 Add data sheet for our "generic" resistor.
2010-10-18 Complete the Opto Endstop with the remaining footprints and create a PCB.
    [OptoEndstop.pcb, OptoEndstop.sch]
2010-10-19 Contribution of Peer Janssen: turn optp endstop connectors 90 deg to eliminate a number of bridges.
    [Gen7Board.pcb]
2010-10-30 Gen7Board: modify the schematic to match the recent turn of the endstop connectors in the PCB.
    [Gen7Board.pcb, Gen7Board.sch]
2010-10-30 Renamed the ATMEGA schematic symbol to match gEDA conventions.
    [Gen7Board.sch]
2010-10-30 Modified the ATmega symbol to show secondary pin symbols as well.
    [Gen7Board.pcb, Gen7Board.sch]
2010-10-30 Made a new ICSP header symbol (for the pin labels) and fitted it into the schematics.
    [Gen7Board.sch]
2010-10-30 Following a contribution by Lanthan: Made a footprint for the ICSP header with matching pin numbering and wired the thing into the pcb.
    [Gen7Board.pcb, Gen7Board.sch]
2010-11-08 Add an outline layer, needed for milling.
    [OptoEndstop.pcb]
2010-12-09 Duplicated Opto Endstops to keep them as Gen2-3 compatibles.
    These have a pinout of 5 V - Signal - GND, which showed up as
    being not ideal for single sided boards. The standard Opto Endstops
    will receive a different pin layout of the connector.
    [OptoEndstopGen2-3Compatible.pcb, OptoEndstopGen2-3Compatible.sch]
2010-12-09 Changed Opto Endstop connectors to match the layout of RAMPS.
    Yes, this is yet again and no, the endstops them selfs are not done yet.
    [Gen7Board.pcb, Gen7Board.sch]
2010-12-09 Modify the Opto Endstop to match the new pinout of the main Board.
    [OptoEndstop.pcb, OptoEndstop.sch]
2010-12-13 Board: save one via at the expense of a slightly larger board.
    [Gen7Board.pcb]
2010-12-13 Board: moved the Reset button ...
    ... to gain space for moving the serial connector.
    [Gen7Board.pcb]
2010-12-13 Board: Move the clock chrystal to a more appropriate place.
    [Gen7Board.pcb]
2010-12-15 Board, by Jacky2k: Allow traces between between reset switch pins.
    Also add a data sheet for that switch and rename the footprint accordingly.
    [Gen7Board.pcb, Gen7Board.sch]
2010-12-15 Board, by Jacky2k: move the reset switch's 5V to Vcc/5VSB.
    Reset was pulled "up" to 5V instead of 5VSB so the processor stayed
    in reset until the power supply turns on, a catch-22 condition.
    [Gen7Board.pcb, Gen7Board.sch]
2010-12-15 Board, by Jacky2k: move temperature sensors from port PB to PA.
    This is neccessary, as only port PA features analog inputs.
    [Gen7Board.pcb, Gen7Board.sch]
2010-12-15 Board: drop fuse R17.
    All known other boards don't have fuses either, so we also
    rely on the power supply's fuse.
    [Gen7Board.pcb, Gen7Board.sch]
2010-12-15 Board: drop fuse R15 as well.
    Unfortunately, no simplification in the PCB layout this time.
    [Gen7Board.pcb, Gen7Board.sch]
2010-12-16 Board: re-introduced pluggable jumpers due to popular demand.
    [Gen7Board.pcb, Gen7Board.sch]
2010-12-16 Board: remove one of the traces to the 5V pins of the ATX20 for simplification.
    [Gen7Board.pcb, Gen7Board.sch]
2010-12-16 Added data sheets for the Pololu board and the A4983 it's self.
2010-12-16 Board: replaced R11, R12 and R13 by 1KOhm.
    As recommended by the Gen2OnABoard Wiki page. Previous value was
    100KOhm.
    [Gen7Board.pcb, Gen7Board.sch]
2010-12-16 Board: connected SLEEP and RESET directly.
    This is hinted in the breakout board data sheet on page 2 and
    page 4 of that document shows this pulls both pins high, due
    to an resistor already on that breakout board.
    [Gen7Board.pcb, Gen7Board.sch]
2010-12-17 Board: removed R1, R5, R7 and R9 as they appear to be obsolete.
    The obsoleteness was found by comparing with other circuits like
    RAMPS, Repic.
    [Gen7Board.pcb, Gen7Board.sch]
2010-12-17 Board: raised R2, R6, R8 and R10 to 100K from 2K7.
    100K should be sufficient to hold this input on High.
    [Gen7Board.pcb, Gen7Board.sch]
2010-12-17 Board: simplified and widened the traces under the Pololus.
    This was possible due to the last two changes.
    [Gen7Board.pcb]
2010-12-18 Board: removed the jumper for MS1 of the Pololus.
    Now this signal is hardwired to High, making it unambiguous, despite
    of the lacking internal pulldown resistor.
    [Gen7Board.pcb, Gen7Board.sch]
2010-12-18 Revert "Board: raised R2, R6, R8 and R10 to 100K from 2K7."
    This was a silly idea, as there are internal pulldown-resistors.
    Changed them now to 1K to have more resistors of the same value.
    [Gen7Board.pcb, Gen7Board.sch]
2010-12-18 Board: specified D1, D2 and D3 to 1N4004, including data sheet.
    [Gen7Board.pcb, Gen7Board.sch]
2010-12-18 Board: corrected D1, D2 and D3's footprint.
    This included using a reverted symbol in the schematics, as
    schematics and layout didn't agree in pin numbering. Yes,
    even with only 2 pins something like this can be wrong.
    [Gen7Board.pcb, Gen7Board.sch]
2010-12-18 Board: moved everything to the center of the layout area and added a 140 x 100 mm outline layer.
    [Gen7Board.pcb]
2010-12-18 Moved the unused solder jumper in a new dir of this name.
2010-12-18 Board: replaced the ATX12V connector with a Molex 4 pin one.
    More important here is to get the connector to the left side.
    [Gen7Board.pcb, Gen7Board.sch]
2010-12-19 Board, by Jacky2k: add de-noise capacitor C14.
    [Gen7Board.pcb, Gen7Board.sch]
2010-12-19 Board: back into the 25 mil grid.
    An unfortunate feature of gEDA is, if you switch measurement units
    from mil to mm, the grid size changes also. This accidently happened
    when th big move was done a few commits earlier.
    [Gen7Board.pcb]
2010-12-19 Smaller C3, C4 footprints Changed the footprints of C3, C4 (capacitors for the crystal) to 100mil footprint for ceramic capacitors.
    [Gen7Board.pcb]
2010-12-19 Board: Jumper between 5V and 5VSB A Jumper was added to short 5V and 5VSB. The 5V pin of the molex connector was connected to the boards 5V, so it is possible to use the board without the 20 pin ATX 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
    [Gen7Board.pcb, Gen7Board.sch]
2010-12-19 Board: Changed footprint of more capacitors to 100mil.
    [Gen7Board.pcb, Gen7Board.sch]
2010-12-19 Board: Cleanup, DRC Check nearly OK
    [Gen7Board.pcb]
2010-12-19 Increase the silk line thickness of the ATX20 to 10 mil.
    This is to match the DRC's expectations.
    [Gen7Board.pcb]
2010-12-19 Board: No more DRC errors, added I2C Header, Moved up the atmega for more space under it
    [Gen7Board.pcb, Gen7Board.sch]
2010-12-19 Board: Connected heater/fan headers to the outside pins
    [Gen7Board.pcb, Gen7Board.sch]
2010-12-19 There's a second data sheet for the inductor.
    This time including the component's wire diameter (0.6 mm).
2010-12-19 Files: Added 3 pin jumper footprint
2010-12-19 Board: Filter for AVCC A L/C Filter for AVCC was added and the 5V to 5VSB bridge jumper was moved
    [Gen7Board.pcb, Gen7Board.sch]
2010-12-19 Added symbol and footprint for a 3-way jumper.
2010-12-19 Board: Moved wrong places GND line away from Q1
    [Gen7Board.pcb]
2010-12-19 Board: re-added licence texts.
    [Gen7Board.pcb]
2010-12-20 Board: moved the ATmega a few mm up.
    This reliefs the space situation below the processor. Spotted
    by Jacky2k.
    [Gen7Board.pcb]
2010-12-20 Board: moved the Reset button a bit to the left.
    This makes room for the ICMP connector. Spotted by Jacky2k.
    [Gen7Board.pcb]
2010-12-21 Board: replaced C5's footprint with an ACY100.
    This is the same as for all the other capacitors of that size.
    It required to turn R30 and L1 as well.
    [Gen7Board.pcb, Gen7Board.sch]
2010-12-21 Board: more space around the drill holes of FET Q1.
    [Gen7Board.pcb]
2010-12-21 Board: add a note about how to choose RT1 and RT2.
    This note was added to the schematic.
    [Gen7Board.pcb, Gen7Board.sch]
2010-12-21 Added data sheet for the TIP120 FET.
2010-12-21 Board: reviewed the TIP120 with it's TO-220 housing.
    [Gen7Board.pcb, Gen7Board.sch]
2010-12-21 Board: stretched the FETs 100 mil apart for more comfort.
    [Gen7Board.pcb]
2010-12-26 Added a sample config.h file for FiveD on Arduino.
2011-01-08 Board: make C1, C2 and C6 all 100 uF.
    [Gen7Board.pcb, Gen7Board.sch]
2011-01-08 Board: set RT1 and RT2 to a default of 4K7.
    [Gen7Board.pcb, Gen7Board.sch]
2011-01-08 Board: give C5 a value, 0.1 uF.
    [Gen7Board.pcb, Gen7Board.sch]
2011-01-08 Board: new serial header footprint.
    The new one is a Molex KK-100 6-pin to avoid plugging in the
    connector the wrong way. As everybody is free to change connectors
    to personal preference, the change in fact just gives a bit more
    space around the header.
    [Gen7Board.pcb, Gen7Board.sch]
2011-01-08 Board: raised copper around 3-pin Molex KK 100 header pins as well.
    The new copper size is 80 mil. Also previously drill sizes mismatched
    between the layout and the footprint.
    [Gen7Board.pcb]
2011-01-08 Board: connect all Pololu's Enable pins to ATmega's PA7.
    This allows to switch off the stepper motor also for power
    supplies not featuring an on/off pin.
    [Gen7Board.pcb, Gen7Board.sch]
2011-01-08 Board: removed H1 and H2 from the schematics.
    These two headers were disconneted a long time ago anyways,
    just cluttering up the schematics.
    [Gen7Board.pcb, Gen7Board.sch]
2011-01-08 Deleted unused footprint Molex KK 156-2.
2011-01-08 Add a data sheet and a footprint for AKL 220-4 connectors.
    These are much more available in Europe than Molex connectors,
    e.g. Reichelt Art.Nr. AKL 220-04.
2011-01-11 Board, by Jacky2k: Added 10K pull-ups for I2C.
    [Gen7Board.pcb, Gen7Board.sch]
2011-01-11 Board, by Jacky2k: add 5-pin header.
    This is to ease access to some of the unused ATmega pins.
    [Gen7Board.pcb, Gen7Board.sch]
2011-01-11 Board: mark all non-GND tracks as "clearline".
    This doesn't change the appearance of the board, but makes laying
    a ground plane much easier.
    [Gen7Board.pcb]
2011-01-12 Board: align mounting holes, and make them pure drill holes.
    [Gen7Board.pcb]
2011-01-15 Board: Change drill size and polygon clearance for FET's mounting holes.
    Drill size is now 3.3 mm, diameter of the clearance is 8 mm,
    both values fitting for M3 srews/nuts/washers. FET's housings
    are _not_ supposed to get electrical contact with GND, at least
    for some types of FETs.
    [Gen7Board.pcb]
2011-01-24 Board: Made the board a little bit smaller.
    Moved the mounting holes accordingly. The board is now 100 x 130 mm.
    [Gen7Board.pcb]
2011-01-24 Board: Added data sheet and footprint for the crystal.
    Also changed this footprint in the layout.
    [Gen7Board.pcb, Gen7Board.sch]
2011-01-24 Board: review the ICMP header, needs more space.
    Also added a data sheet and fit the reviewed footprint into the
    layout.
    [Gen7Board.pcb]
2011-01-24 Board: reviewd Molex KK 100 pins.
    Did this for both, 3-pin (Endstops) and 6-pin (Serial). Drill hole
    is now 44 mil (1.12 mm), copper = solder stop mask = 80 mil.
    [Gen7Board.pcb]
2011-01-24 Board, by Jacky2k: more copper around the jumper headers.
    This includes the 5-pin MISC header.
    Note there's a bug in the very popular 2009 version of PCB,
    which disallows the usage of dashs (-) in some footprint file names.
    [Gen7Board.pcb, Gen7Board.sch]
2011-01-24 Board: switch remaining 100 nF value to 0.1 uF to match majority.
    No functional change.
    [Gen7Board.pcb, Gen7Board.sch]
2011-01-25 Board: drill size of the Molex 156 connectors is now 70 mil (1.78 mm).
    [Gen7Board.pcb]
2011-01-25 Board: Allow both, 0.200" and 4 mm spaced motor connectors.
    Funnily, the 4 mm ones are apparently better available in states with
    imperial measurement system, while the others are found easier in
    europe with it's metric system.
    Anyways, to get room for the double-footprint, the hole Pololu area
    had to go down 3 rasters (75 mil).
    [Gen7Board.pcb, Gen7Board.sch]
2011-01-27 Board: add the connection to all EN pins in the schematic as well.
    Accidently, this was forgotten when drawing this into the board's
    layout, so the board remains unchanged.
    [Gen7Board.pcb, Gen7Board.sch]
2011-02-02 H21LOB: make the mounting hole pure drill holes.
    Also, apply this to both Opto Endstops.
    [OptoEndstop.pcb, OptoEndstopGen2-3Compatible.pcb]
2011-02-02 Board: move motor connectors up 25 mil to make room for the connector's snappers.
    [Gen7Board.pcb]
2011-02-02 Board: GND tracks shouldn't have polygon clearance.
    [Gen7Board.pcb]
2011-02-02 Added data sheet for polarized capacitors.
2011-02-02 Board: reviewed all polarized capacitors.
    This included a new footprint for the 10uF ones. Footprint
    for the 100uF ones are unchanged, as 35V versions have the currently
    designed spacing. 25V ones are smaller, but the Pololus are spec'd
    for 35V, so some people may choose to use that current.
    [Gen7Board.pcb, Gen7Board.sch]
2011-02-02 Board: make the 12V tracks to the left wider.
    C1 moved slightly, but no additional room occupied.
    [Gen7Board.pcb]
2011-02-02 Board: tidied up texts a bit.
    No functional, track or element change.
    [Gen7Board.pcb]
2011-02-26 Gen7Board: change a "4k7" to "4K7".
    Component values have to match case-sensitive to be recognized
    as being the same.
    [Gen7Board.pcb, Gen7Board.sch]
2011-03-07 Both Endstops: reduce drill size for the 3 mm LEDs to 30 mil / 0.76 mm.
    This also reduces the number of drills from 4 to 3, which is about as
    good as we can get it.
    [OptoEndstop.pcb, OptoEndstop.sch, OptoEndstopGen2-3Compatible.pcb, OptoEndstopGen2-3Compatible.sch]
2011-03-07 Endstops: move the outline layer to the solder side.
    This simplifies handling with Visolate.
    [OptoEndstop.pcb, OptoEndstopGen2-3Compatible.pcb]
2011-03-07 Endstops: make all resistors to have round pins.
    [OptoEndstop.pcb, OptoEndstop.sch, OptoEndstopGen2-3Compatible.pcb, OptoEndstopGen2-3Compatible.sch]
2011-03-07 Endstops: make LEDs have round pins.
    [OptoEndstop.pcb, OptoEndstopGen2-3Compatible.pcb]
2011-03-07 Endstops: make optical interrupter switch to have all round pins.
    Now all pins are round and Visolate shouldn't complain about
    "TBD plogon mode" any more.
    [OptoEndstop.pcb, OptoEndstopGen2-3Compatible.pcb]
2011-03-07 Endstops: re-apply a small copper ring around mounting holes.
    This should avoid Visolate to pull an isolation path right through
    these mounting holes, risking a short by the mounting screw.
    [OptoEndstop.pcb, OptoEndstopGen2-3Compatible.pcb]
2011-03-07 Endstops: rearrange tracks a bit for better Voronoi paths.
    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
    [OptoEndstop.pcb, OptoEndstopGen2-3Compatible.pcb]
2011-03-07 Board: replace the TIP120 with an IRFZ 44N.
    The IRFZ 44N can switch 41 A instead of 5 A and costs only about
    20 cents more.
    [Gen7Board.pcb, Gen7Board.sch]
2011-03-07 Board: raise the reset switch drill holes to 40 mil = 1.02 mm.
    [Gen7Board.pcb]
2011-03-07 Endstops: review the Resistor footprint yet again.
    This time, make the silk rectangle bigger to make room for the
    designation inside.
    [OptoEndstop.pcb, OptoEndstopGen2-3Compatible.pcb]
2011-03-07 Board: use the footprints also used in the Endstops.
    This also raises the resistor's drill sizes to 30 mil, getting
    the 28 mil drill closer to be obsolete.
    [Gen7Board.pcb, Gen7Board.sch]
2011-03-07 Board: make all vias the same size.
    This removes this funny 39 mil drill.
    [Gen7Board.pcb]
2011-03-07 Board: drill the ATmega's socket with 30 mil as well.
    [Gen7Board.pcb, Gen7Board.sch]
2011-03-07 Board: drill the chrystal with 30 mil as well.
    This finally makes the 28 mill drill obsolete, reducing the number
    of drills to now 10.
    [Gen7Board.pcb]
2011-03-07 Board: replace the 5 mm LEDs with 3 mm ones.
    This also removes the requirement for the 43 mil drill, so we have
    now 9 drill sizes.
    [Gen7Board.pcb, Gen7Board.sch]
2011-03-07 Board: use the same mounting holes as with the Endstops.
    This also gives them a small copper ring, avoiding shorts by the
    mounting screw when milling with Voronoi paths.
    [Gen7Board.pcb]
2011-03-07 Board: introduce a new layer for texts on the solder side.
    This helps to distinguish texts from tracks and pins, needed when
    manufacturing with Voronoi paths.
    [Gen7Board.pcb]
2011-03-08 Board: hide the enforced names of the motor connectors.
    There was descriptive text already, which was slightly moved
    away from the outline.
    [Gen7Board.pcb]
2011-03-09 Board: have 3 jumpers for each of the possible 5V sources.
    These 3 sources are 5VSB from the ATX20, 5V from the Serial
    connector or 5V from the Molex 4-pin connector. You're supposed to
    fill exactly ONE of these jumpers at a time.
    [Gen7Board.pcb, Gen7Board.sch]
2011-03-09 Board: made diode pins round and only 40 mil = 1.02 mm drill size.
    [Gen7Board.pcb]
2011-03-09 Board: reduced the ICSP header drill size to 40 mil = 1.02 mm.
    Also fix the solder mask of this connector.
    [Gen7Board.pcb]
2011-03-09 Board: reduced drill size of the serial connector to 40 mil.
    Also fixed the solder mask of this connector.
    [Gen7Board.pcb]
2011-03-10 Board: Reduced the drill size if the Molex KK100 3-Pin to 40 mil.
    This finally removes the requirement for the 44 mil drill. The
    solder mask of these connectors was corrected also.
    [Gen7Board.pcb]
2011-03-10 Board: add a solder mask relief to all vias.
    We have a unusual requirement here, as vias are not really
    used as vias, mut as pin holes for wire bridges.
    [Gen7Board.pcb]
2011-03-10 Board: make 100 uF caps have all round pins and a plus sign.
    [Gen7Board.pcb]
2011-03-10 Board: make 10 uF caps have all round pins and a plus sign.
    [Gen7Board.pcb]
2011-03-10 Board: make 0.1 uF caps have all pins round.
    [Gen7Board.pcb]
2011-03-10 Board: make the coil have all round pins.
    This finally makes the board have round pins only, so the Gerber
    output is Visolate-compatible.
    [Gen7Board.pcb, Gen7Board.sch]
2011-03-10 Board, Endstops: add a plus sign to the LEDs silk screen.
    [Gen7Board.pcb, OptoEndstop.pcb, OptoEndstopGen2-3Compatible.pcb]
2011-03-10 Endstops: delete some garbage text in the schematics.
    [OptoEndstop.sch, OptoEndstopGen2-3Compatible.sch]
2011-03-10 Endstops: use the same symbol for the LEDs in the schematics as Board.
    The old symbol actually had an incompatible pin numbering, so the
    LED ended up the wrong way!
    [OptoEndstop.pcb, OptoEndstop.sch, OptoEndstopGen2-3Compatible.pcb, OptoEndstopGen2-3Compatible.sch]
2011-03-10 All Layouts: review DRC rules.
    minimum copper spacing: 16 mil
    minimum copper width: 10 mil
    minimum silk width: 5 mil
    They had unequal values before.
    [Gen7Board.pcb, OptoEndstop.pcb, OptoEndstopGen2-3Compatible.pcb]
2011-03-10 Board: add the version number to the copper text.
    [Gen7Board.pcb]
2011-03-10 Board: fix the MISC header's solder mask.
    [Gen7Board.pcb]
2011-03-10 Board: fix solder mask of 2-pin jumpers.
    [Gen7Board.pcb]
2011-03-10 Board: fix motor connector AKL_220-4 solder mask.
    As an exception, the solder mask relief was too big this time.
    [Gen7Board.pcb]
2011-03-10 Remove an unused footprint.
2011-03-10 Board: fix the Molex 4-pin's solder mask.
    [Gen7Board.pcb]
2011-03-10 Board: connect HEATER1 and HEATER2 with PWM-able pins.
    Sometimes it's astonishing how long it takes to find such essential
    flaws.
    [Gen7Board.pcb, Gen7Board.sch]
2011-03-10 Board: tidy up schematics a bit in the MOSFET area.
    [Gen7Board.sch]
2011-03-14 Board: make all tracks meant as wire bridges 50 mil wide.
    Previously, they had different widths.
    [Gen7Board.pcb]
2011-03-22 Start a script for making release documents.
    The plan is to offer gerbers, schematics and layouts for the
    latest release in the repository, so everybody can look there,
    even with not having gEDA handy.
    For now, schematics are produced.
2011-03-22 Release Maker: should be complete now.
    This commit adds all the layout output files.
    There are four files for each piece of electronics:
    - Schematic
    - Layout PNG
    - Layout PDF
    - Zip archive with Layout Gerbers
2011-03-27 Add Arduino support.
    This includes:
    - Boards.txt describing four variants of Gen7's.
    - The stk500v2 bootloader from Peter Fleury, adjusted for our needs.
    - Library files taken unchanged from the Sanguino project.
    - A make script to build a nice package.
2011-03-27 tools/make-release-files.sh: also create an archive for Arduino IDE support.
2011-04-03 Added data sheet for the TCST 11xx/21xx optical sensors.
2011-04-06 Added symbol and footprint for the TCST optical sensor.
    The footprint is for the TCST 11xx series, which doesn't have
    mounting holes.
2011-04-06 Endstop: overhauled the design to use a TCST1103 optical interrupter.
    The design is a bit a compromise. As we want the LED to light up
    only with an interrupted switch, there is a balance between
    sending voltage to the signal line and sending current to the LED.
    R3 has most influence in this balance. Bigger values give more current
    to the signal, lower values more current to the LED.
    The current balance gives 4 Volts to the signal and lets the LED
    light up to about 80%.
    Another design solution would be to connect the LED to Vcc instead of
    GND, giving both, full voltage to the signal and full current to the LED.
    However, the signal is inverted then, lighting the LED all the time.
    Adding a tr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
    [OptoEndstop.pcb, OptoEndstop.sch]
2011-05-09 Removed the Teacup sample config file, as it is outdated.
    A working one will appear in the Teacup repository as soon as possible.
2011-05-10 Removed OptoEndstopGen2-3Compatible as it's obsolete now.
    [OptoEndstopGen2-3Compatible.pcb, OptoEndstopGen2-3Compatible.sch]
2011-05-10 Board: changed the version print from 1.1 to 1.2.
    [Gen7Board.pcb]
2011-05-11 Removed H21LOB symbol and footprint.
2011-05-11 Endstop: add plus signs to the photo interrupter footprint.
    This should clarify how to insert that thing into the PCB.
    [OptoEndstop.pcb]
2011-05-23 Add combined footprint for the motor headers.
    As ever only one of Molex 156 of AKL 220 connector can be soldered
    in, having two seperate symbols in the schematic isn't ideal. So,
    the goal is now to do this redundacy in the footprint only.
2011-05-23 Make use of this new combi footprint ...
    ... and allow the GND track near the top border to be wider, as
    there is more space now.
    [Gen7Board.pcb, Gen7Board.sch]
2011-05-25 Removed the Molex .156 and the AKL 220 connector.
    They're no longer used and were replaced by the Combi-4 footprint.
2011-05-25 Add a Combi-2 footprint, derived from the Combi-4 one.
    This is to be used for the heater connectors, as these draw even
    more current than the motors.
2011-05-25 Remove the MOSFET for the fan.
    This has three reasons:
    1 A questionaire resulted in nobody actually using a fan.
    2 If you really want a fan, connect it to the power supply
    directly. Like the PSU, it will switch off at end of printing.
    3 Cost and board space, of course. Cost saving is about EUR 1.-.
    No worries, the board space will be reused quickly, bigger headers
    are already lurking around the corner.
    [Gen7Board.pcb, Gen7Board.sch]
2011-05-25 Replace the heater connectors with that new Combi-2 type.
    Several enhancements:
    - Only two pins -> less confusion.
    - Thicker pins -> more current possible.
    - You can use screw terminals.
    [Gen7Board.pcb, Gen7Board.sch]
2011-05-25 Remove the I2C header.
    Apparently, nobody uses this, so save cost and board space.
    [Gen7Board.pcb, Gen7Board.sch]
2011-05-26 Add a Molex KK100 2-pin header.
2011-05-26 Replace 3 pin thermistor headers with 2 pin ones.
    This not only lowers the price by a few cent, it also allows a
    simpler routing, removes a wire bridge and makes it unambiguous
    on where the thermistor should be connected.
    [Gen7Board.pcb, Gen7Board.sch]
2011-05-26 Add a few more data sheets regarding power headers.
    Also remove ones no longer in use.
2011-06-03 Board: replaced the footprint for the ATX20 connector.
    The footprint has now 24 pins for compatibility with
    ATX24 power supplies.
    [Gen7Board.pcb, Gen7Board.sch]
2011-06-06 Board: raise power debug LED pre-resistors to 1K.
    Formerly this was 180 ohms. With 1K the light is still clearly visible.
    [Gen7Board.pcb, Gen7Board.sch]
2011-06-06 Board: the debug LED is back!
    [Gen7Board.pcb, Gen7Board.sch]
2011-06-06 Board: made Standby and Debug LED yellow.
    [Gen7Board.pcb, Gen7Board.sch]
2011-06-06 Board: add another disk power type connector for supplying heaters.
    Also, the 12 volts stuff was divided into two parts. This allows
    to have different voltages for heaters and motors without making
    things more complex for newbie users.
    [Gen7Board.pcb, Gen7Board.sch]
2011-06-07 Board: removed a now obsolete wire bridge.
    [Gen7Board.pcb]
2011-06-07 Board: made the 20 MHz crystal the default.
    [Gen7Board.pcb, Gen7Board.sch]
2011-06-07 Board: reduced the drill size of the MOSFETs to 40 mil = 1.02 mm.
    In the data sheet 0.66 to 0.93 mm are specified, so this is safe.
    Seven drill sizes are left, now.
    [Gen7Board.pcb]
2011-06-07 Added data sheet for the Molex KK 156 header.
    These are the headers used for the motor and heater connectors.
2011-06-08 Board: reduce the drill size of screw terminals to 40 mil / 1.02 mm.
    Both, the screw terminals coming from Reichelt as well as those
    coming with Gen2 electronics have 0.9 mm pins, so 1.0 mm is
    totally sufficient ... and yet another custom drill size less.
    [Gen7Board.pcb]
2011-06-08 Board: reduced the ATX24's drill size to 1.3 mm.
    This was 1.4 mm and takes account for the fact Gen7 is single sided,
    so no solder can flow into the hole anyways.
    [Gen7Board.pcb]
2011-06-08 Board: made drill holes for the Molex 4 Pin and Molex 156 both 1.6 mm.
    This is a bit smaller than recommended by Molex, which takes account
    for the fact Gen7 is single sided. Five drill sizes now, which is about
    as good as we can get.
    [Gen7Board.pcb]
2011-06-08 Board: made traces from the MOSFETs a bit shorter and thicker.
    There's a lot of current and this also makes a bit more room.
    [Gen7Board.pcb]
2011-06-08 Board: same clearance against copper planes for all tracks (32 mil).
    The endstop PCB was already fine.
    [Gen7Board.pcb]
2011-06-08 Both PCBs: raise minimum track width to 30 mil.
    Was 20 mil before. According to users of the toner etching method,
    wider tracks are more reliable. So, increasing track width without
    lowering minimum copper track (important for isolation milling)
    is a good thing.
    [Gen7Board.pcb, OptoEndstop.pcb]
2011-06-11 Board: remove the Debug LED again.
    This was added too early, as this pin is also used for the X_MIN
    endstop. When introducing SD card support this endstop is expected
    to go elsewhere, though.
    [Gen7Board.pcb, Gen7Board.sch]
2011-06-11 Board: make the MOSFETs upright.
    This should allow better cooling and attaching a heatsink. Effectively,
    it just replaces the silk of the footprint ...
    Also made the GND trace there even thicker.
    [Gen7Board.pcb, Gen7Board.sch]
2011-06-11 Removed two footprints which are likely never used.
2011-06-14 Board: bump printed version number to 1.3, note new licence.
    [Gen7Board.pcb, Gen7Board.sch]
2011-06-15 Board: align C1 with the nearby connector.
    Just a cosmetic change.
    [Gen7Board.pcb]
2011-06-15 Board: align CONN3 to CONN2.
    Also purely cosmetic.
    [Gen7Board.pcb]
2011-06-15 Board: aligned Temp connectors with the surrounding connectors.
    Another cosmetics without functional change.
    [Gen7Board.pcb]
2011-06-25 Endstop: add a 'E' and 'D' sign to the TCST1103/2103 footprint.
    The previous one wasn't unambiguous and nobody told me for several
    months ... uäääh!
    [OptoEndstop.pcb]
2011-06-29 Board: fix a misaligned mounting hole.
    The misalignment was probably introduced unintentionally.
    [Gen7Board.pcb]
2011-06-29 Board: fixed the designator of the Pololus on the silk screen.
    [Gen7Board.pcb]
2011-07-07 Add a small setup test firmware.
    This is for use right after assembly, to make sure basic things work.
    Nothing fancy, but it compiles in the Arduino IDE.
2011-08-11 Bootloader: replace tabs with spaces, remove spaces at line endings.
    This is a purely cosmetical change.
    [command.h, stk500boot.c]
2011-08-12 SetupTest: turn the other heater LED off while one is blinking.
    Formerly, the status of the second heater was undefined, which sometimes
    led to user confusion.
2011-08-16 arduino support: adjust boards.txt to new fuse settings.
2012-12-09 Make Gen7 Arduino IDE Support 2.0 release.
    New Features:
    - Updated the Gen7 Arduino IDE Support package for Arduino 1.0.
2012-12-09 Make Gen7Board 1.4 release.
    - Added the extension header.
    - Moved motor heaters from KK156 to KK100 ones.
    - Reduced the number of endstops to 3.
    - Connect the thermistor to 5V Standby.
    - Better GND routing for even more accurate temperature readings.
    - Resistors between ATmega and MOSFETs now 10 Ohms.
    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
    [Gen7Board.pcb, Gen7Board.sch]
2012-12-09 Make Gen7Board 1.4.1 release.
    - Distinction between extruder and bed circuitry.
    - Bigger MOSFET for the heated bed, making the heatsink obsolete.
    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
    [Gen7Board.pcb, Gen7Board.sch]
2012-12-09 Make ExtensionBoard-USB-B 1.0 release.
    New design. Features:
    - Establish USB connectivity using the Microchip MCP2200.
    - Plugs into the Extension Board header.
    - Makes the USB-TTL adapter obsolete.
    [ExtensionBoard-USB-B.pcb, ExtensionBoard-USB-B.sch]
2013-01-22 Make Gen7Board-AVR 1.5 release.
    - The USB adapter is now on the main board. Pretty much what's
    on the ExtentionBoard-USB-B already, making this obsolete.
    - Noise cancelling coil for AVcc now 10 uH. This makes Gen7
    compatible with firmwares supporting LCD displays. Previously,
    hooking up a display would trigger the brown-out-detector often.
    [Gen7Board-AVR.pcb, Gen7Board-AVR.sch]
2013-01-22 Make SevenSwitch 1.1 release.
    - Better, bigger MOSFET (IRLB8743).
    - Option for a screw terminal power supply.
    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
    [SevenSwitch.pcb, SevenSwitch.sch]
2013-01-30 Bootloader: fix it for 16 MHz ATmegas.
    Now, this was an unexpected one: the Gen7 Arduino IDE Support
    package's bootloader didn't work on 16 MHz chips and nobody
    told me! Finally, Simon Fitzback is my hero. He told me about
    the fault, I modified a Gen7 to 16 MHz found it myself. A really
    small change.
    The technical cause is, the single speed UART clock ist too inaccurate
    for 16 MHz. Double speed is better. On 20 MHz, both clocls are
    equally accurate, see ATmega's data sheet.
    [stk500boot.c]
2013-01-30 Arduino support: rebase library onto Arduino 1.0.3.
2013-01-31 Rename SetupTest.pde to SetupTest.ino.
    That's Arduino IDE's new file suffix.
2013-01-31 Make Gen7 Arduino IDE Support 2.1 release.
    - 16 MHz bootloaders actually work.
    - Rebased on Arduino 1.0.3.
    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
2013-08-11 Make SevenSwitch 1.2 release.
    - Pulldown resistor on the MOSFET gate for fewer chances to blow it.
    - Screw terminal footprint on the power supply side removed again,
    because it turned out these terminals fit into the holes for the
    disk power connector just fine.
    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
    [SevenSwitch.pcb, SevenSwitch.sch]
2013-08-25 Add all used footprints.
2014-09-24 Add USB tool.
    This is a tool to run MCP2200-based devices on Mac OS X prior to v10.7.
2016-02-18 Make Gen7Board-ARM 2.0 release.
    - ATmega replaced by NXP LPC1114FN28, a 32-bit CPU.
    - Signal voltage to 3.3 volts.
    - Three jumpers for microstepping selection instead of two.
    - External reset / emergency stop connector.
    - Connector for always on fans (5/7/12 volts).
    - Extension Board connector replaced by two SPI connectors.
    - Thermistor resistors 1K/4K7 instead of 4K7/4K7.
    - MOSFET driver and voltage regulator to adjust for 3.3 V signal
    voltage.
    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
    [Gen7Board-ARM.pcb, Gen7Board-ARM.sch, Gen7Board-AVR.pcb, Gen7Board-AVR.sch]
